isparkes/4-digit-wemos-clock/Hardware/controller-pcb/4DigitIN12Main.csv

Id | Designator | Package | Quantity | Designation | Supplier and ref
1 | L1 | Inductor-100mH | 1 | 100uH
2 | Y1 | Crystal_DS10_d1.0mm_l4.3mm_Vertical | 1 | Crystal
3 | C6,C8,C12,C14 | C025-024X044 | 4 | 100nF
4 | C11 | C025-024X044 | 1 | 680pF
5 | R2,R6,R7 | R-0207_2V | 3 | 10k
6 | R3 | R-0207_2V | 1 | R
7 | R4 | R-0207_2V | 1 | 390k
8 | R5 | R-0207_2V | 1 | 2k2
9 | U6 | K155ID1_DIL16 | 1 | K155ID1
10 | Q1 | TO-92_inline_2N3906 | 1 | 2N3906
11 | J2,J1 | Header_MA10-1_narrow | 2 | Conn_01x10
12 | MH1,MH1,MH1,MH1 | MountingHole_3.2mm_M3 | 4 | MountingHole_3.2mm_M3
13 | LED1,LED2,LED3,LED4 | WS2812B | 4 | WS2812B
14 | R1 | R_2W | 1 | 2R2 2W
15 | D1,D3 | Diode_DO-41_SOD81_Vertical_AnodeUp | 2 | UF4007
16 | D2 | Diode_DO-41_SOD81_Vertical_AnodeUp | 1 | 1N5819
17 | C4,C3,C2,C1 | C_1206_HandSoldering | 4 | 100nF
18 | Q2 | TO-220-3_H | 1 | IRF740
19 | U1 | 74HC595_DIL16 | 1 | 74HC595
20 | U5 | DS1307_DIL8 | 1 | DS1307+
21 | U4 | MC34063_DIL8 | 1 | MC34063A
22 | U2 | WeMos_D1_mini_board_flipped | 1 | WeMos_mini
23 | SV1 | Header_MA04-1 | 1 | CONN_FRONT
24 | BT1 | CR1220-CoinCell | 1 | Battery_Cell
25 | J4 | Header_MA03-1_Small | 1 | Conn_01x03
26 | W1 | TESTPAD_P1-13 | 1 | 5V
27 | W2,W3 | TESTPAD_P1-13 | 2 | GND
28 | W4 | TESTPAD_P1-13 | 1 | 170V
29 | J3 | Header_MA02-1 | 1 | CONN_01X02
30 | C13 | C_Radial_D6.3_L11.2_P2.5 | 1 | 2.2uF
31 | C10,C9,C7 | C_Radial_D6.3_L11.2_P2.5 | 3 | 220uF
32 | RV1 | Potentiometer_Trimmer_Bourns_3296X | 1 | POT
33 | SW1 | SW_Tactile_SPST_Angled_PTS645Vx31-2LFS | 1 | SW_DIP_x01
34 | U3 | TO-220-3_H | 1 | L7805
