isparkes/4-digit-wemos-clock/Hardware/in-2-display/4-Digit-IN-2-Dimensions.pdf

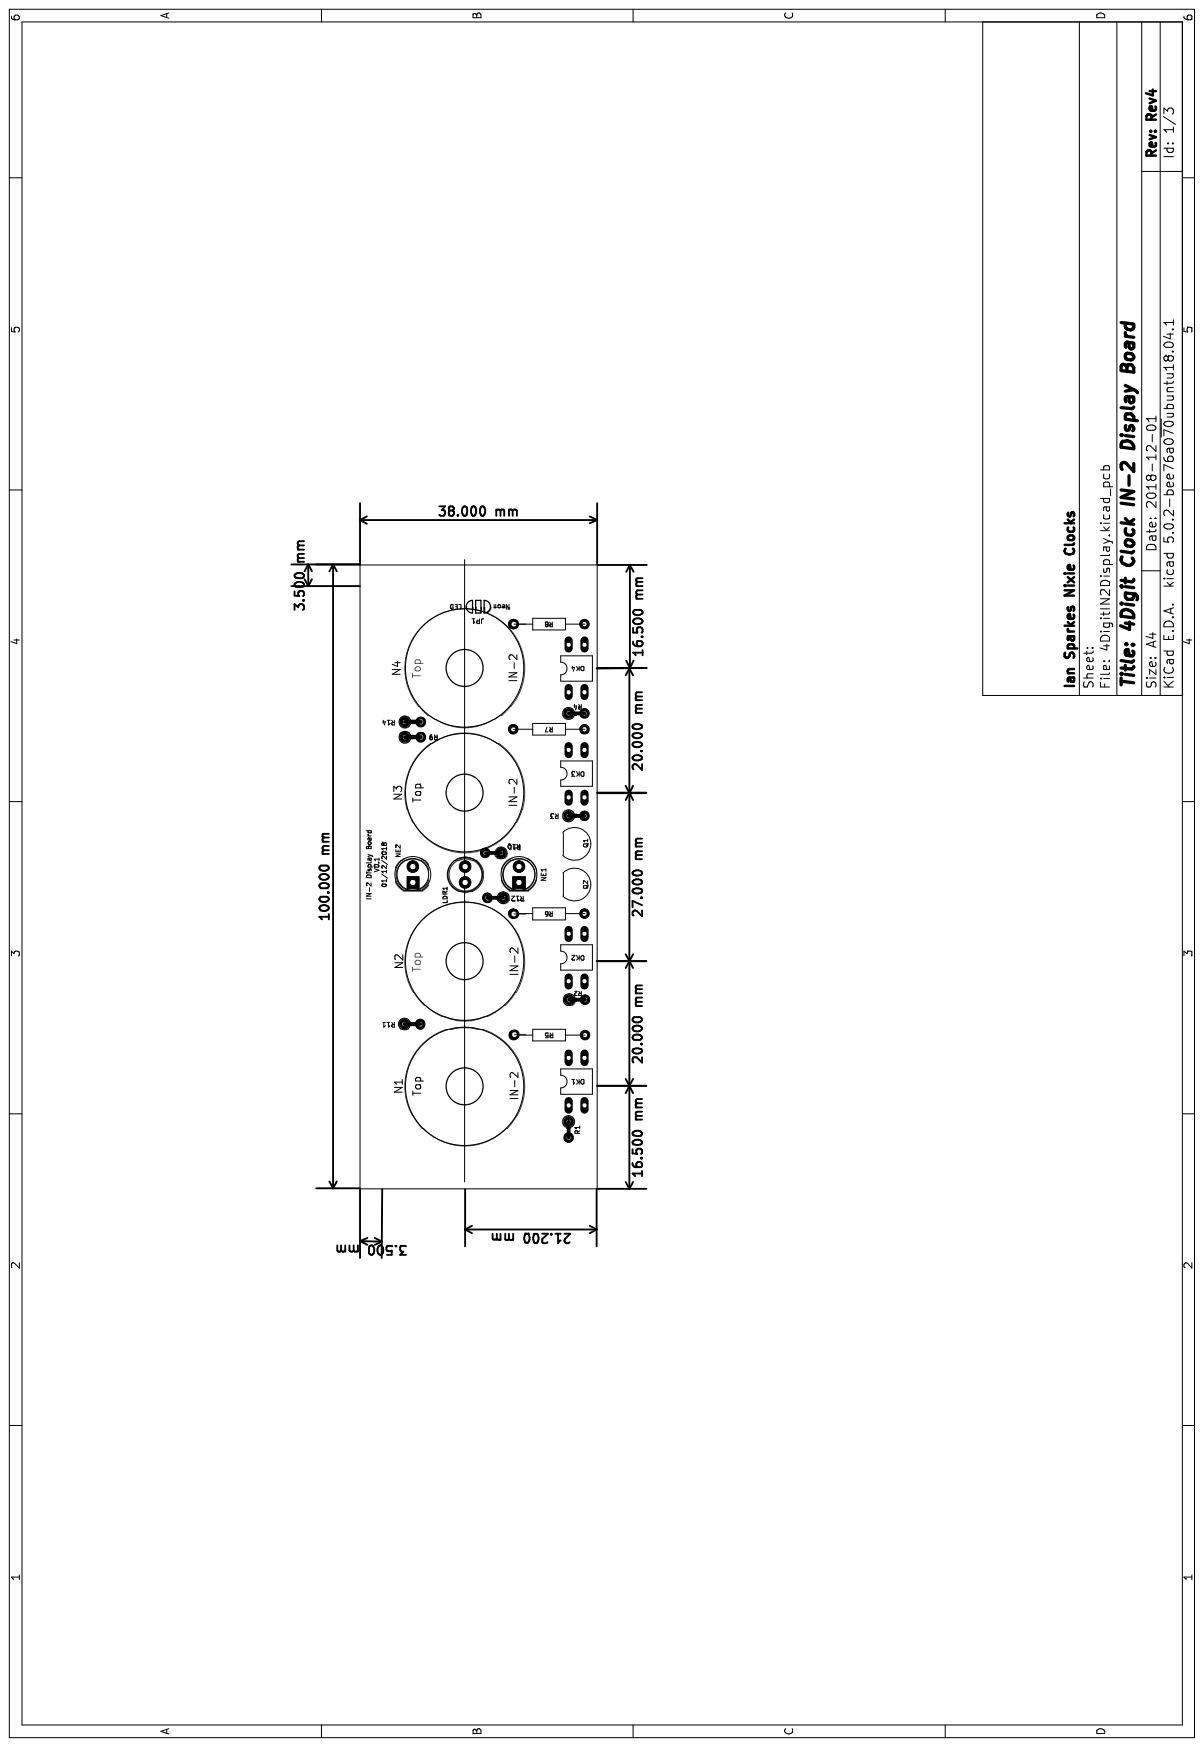
[picture p1: page 1]
