isparkes/4-digit-wemos-clock/Hardware/controller-pcb/4-Digit-Main-Dimensions.pdf

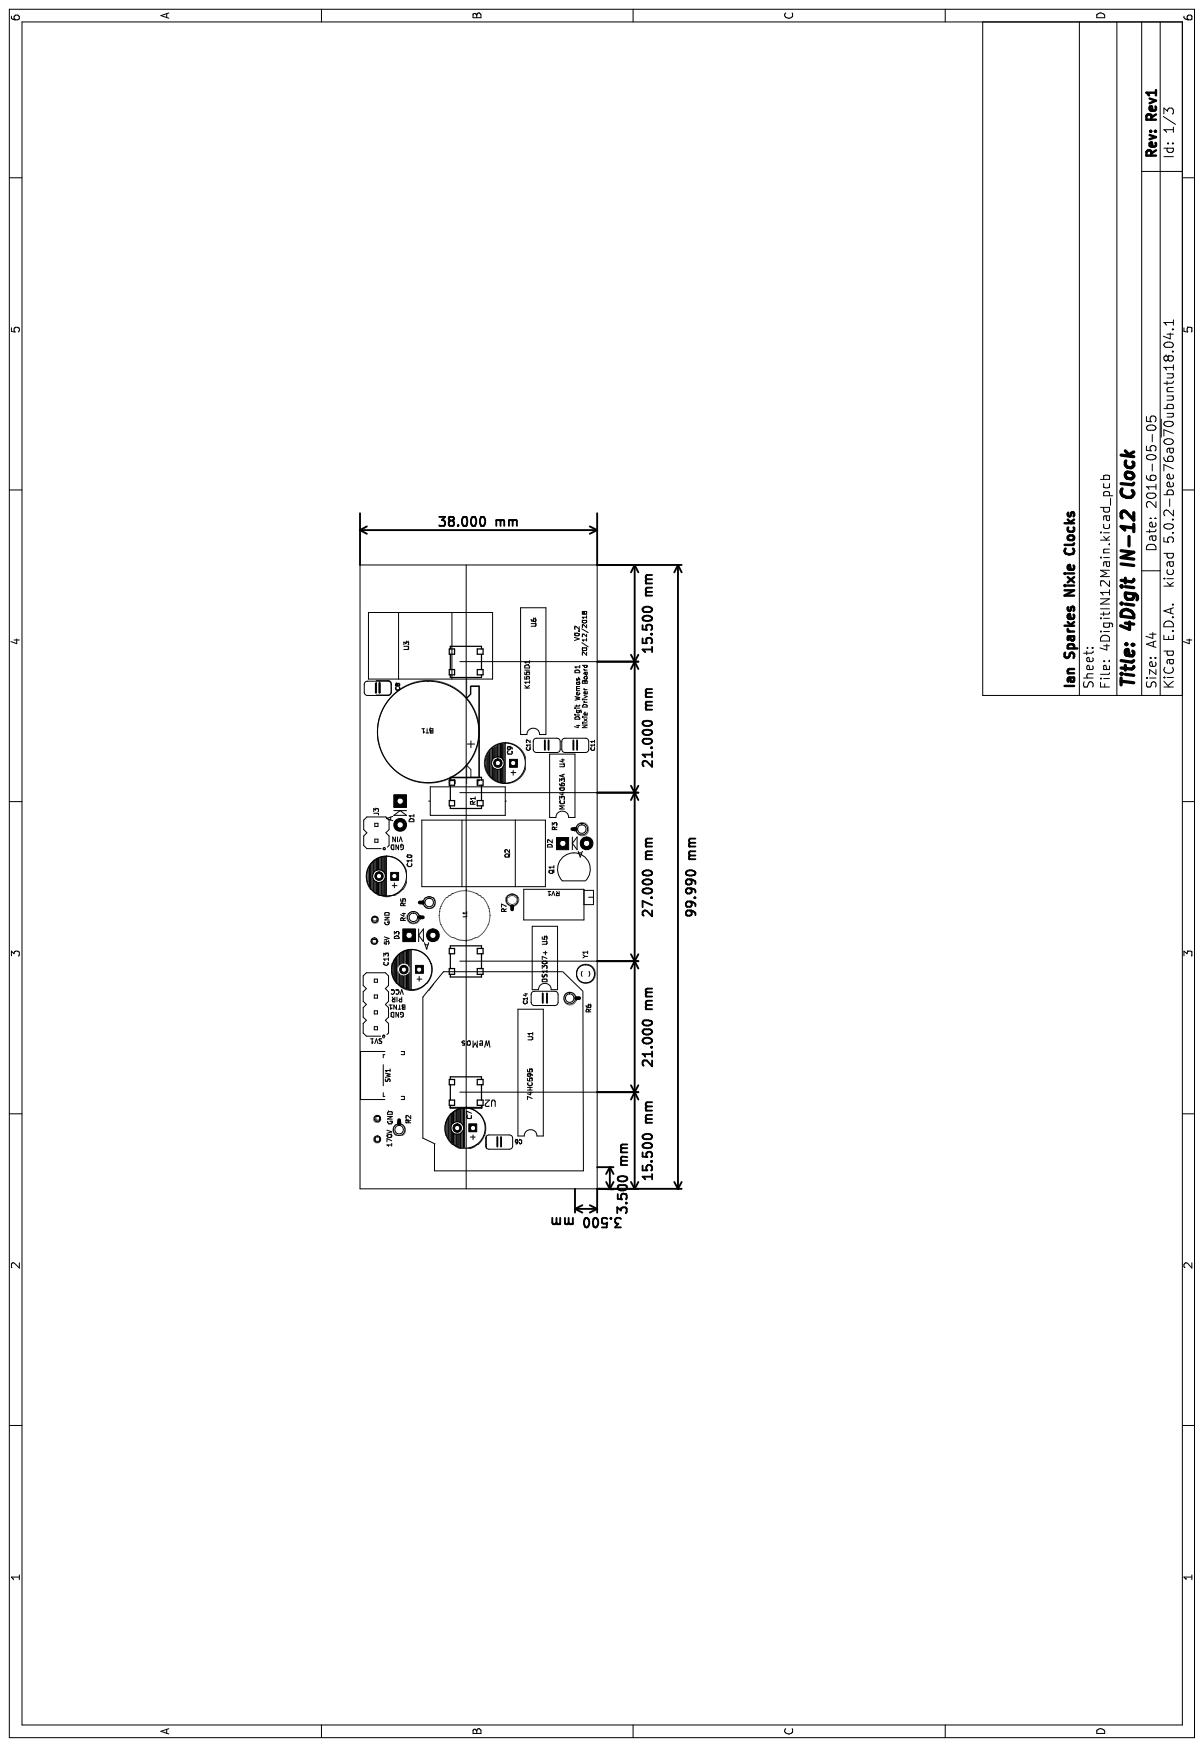
[picture p2: page 1]
