isparkes/4-digit-wemos-clock/Software/main.cpp

//**********************************************************************************
//* ESP8266 4-Digit Nixie Clock                                                    *
//* Copyright (c) 2018-2026 Ian Sparkes. All rights reserved.                      *
//*                                                                                *
//* Free for non-commercial use. Commercial use needs a licence from the author.   *
//* See the LICENSE file in the repository root for the full terms.                *
//* Contact: nixie@protonmail.ch  |  https://www.nixieclock.biz                    *
//**********************************************************************************

//**********************************************************************************
//* Main code for an ESP8266 based Nixie/VFD clock. Features:                      *
//*  - WiFi Clock configuration interface                                          *
//*  - Real Time Clock interface for DS1307+                                       *
//*  - Digit fading with configurable fade length                                  *
//*  - Digit scrollback with configurable scroll speed                             *
//*  - Configuration stored in Flash (JSON)                                        *
//*  - Low hardware component count (as much as possible done in code)             *
//*  - Single button operation with software debounce                              *
//*  - Automatic dimming, using a Light Dependent Resistor                         *
//*  - RGB back light management using individually addressable WS2812B            *
//*  - PIR/motion sensor to turn off display when no one is around                 *
//*                                                                                *
//*   Built with PlatformIO. The board settings below are configured in            *
//*   platformio.ini at the repository root, not in an IDE menu:                   *
//*                                                                                *
//*    Board: LOLIN (Wemos) D1 R2 & mini   (board = d1_mini)                       *
//*    Flash: 80MHz, CPU: 160MHz, Upload speed: 921600                             *
//*    Flash size: 4M (1M SPIFFS)          (eagle.flash.4m1m.ld)                   *
//*    lwIP Variant: v2 Higher Bandwidth (no features)                             *
//*                                                                                *
//*    pio run              - build                                                *
//*    pio run -t upload    - build and flash over USB                             *
//*    pio device monitor   - serial console at 115200 baud                        *
//*                                                                                *
//*  nixie@protonmail.ch                                                           *
//*                                                                                *
//**********************************************************************************
//**********************************************************************************
// Standard Libraries
#include <Arduino.h>
#include <Wire.h>

// Clock specific libraries. Versions are pinned in platformio.ini and fetched
// automatically on the first build - nothing needs installing by hand.
#include <TimeLib.h>            // paulstoffregen/Time (^1.6.1)
#include <NeoPixelBus.h>        // makuna/NeoPixelBus (^2.7.3)
#include <WiFiManager.h>        // tzapu/WiFiManager (^0.16.0)
#include <ArduinoJson.h>        // bblanchon/ArduinoJson (^5.13.2 - the v6/v7 API differs)

// Other parts of the code, broken out for clarity
#include "Globals.h"
#include "ClockButton.h"
#include "DebugManager.h"
#include "Transition.h"
#include "DisplayDefs.h"
#include "ClockUtils.h"
#include "ClockDefs.h"
#include "ESP_DS1307.h"
#include "LEDManager.h"
#include "NtpAsync.h"
#include "HtmlServer.h"
#include "SPIFFS.h"

// Feature configuration (append "_OFF" to switch off)
#define FEATURE_FADE
#define FEATURE_SCROLL
#define FEATURE_PREHEAT_OFF
#define FEATURE_STATUS_LEDS_OFF
#define FEATURE_PIR
#define FEATURE_EXT_LEDS_OFF
#define FEATURE_LED_MODES

#define DEBUG_OFF

NtpAsync ntpAsync;

//**********************************************************************************
//**********************************************************************************
//*                               ISR Display Multiplex                            *
//**********************************************************************************
//**********************************************************************************
#define INT_MUX_COUNTS         800
#define COUNTS_PER_DIGIT       20
#define COUNTS_PER_DIGIT_DIM   8

#define NEXT_DIGIT    B00000000
#define SWCH_DIGIT    B01000000
#define OFF__DIGIT    B10000000
#define BLNK_DIGIT    B11000000

volatile byte digitStep = 0;
volatile byte phaseStep = 0;

// Overall Phase array
byte phaseTime[][DIGIT_COUNT] = {{ 0, 0, 0, 0},
                       { 0, 0, 0, 0},
                       { 0, 0, 0, 0}};

// display arrays
byte valueBufferCurr[DIGIT_COUNT] = { 0, 0, 0, 0};
byte valueBufferPrev[DIGIT_COUNT] = { 0, 0, 0, 0};

// Cached values for this digit: updated only between digits
byte ptCache[] = {20 | NEXT_DIGIT, 0, 0};
byte na = 0;
byte cna = 0;

//**********************************************************************************
//* Forward declarations                                                           *
//*                                                                                *
//* The Arduino IDE generated these automatically from the .ino file. Under         *
//* PlatformIO this is a plain C++ translation unit, so they are declared here.     *
//**********************************************************************************
ICACHE_RAM_ATTR void digitOn(byte digit, byte value);
ICACHE_RAM_ATTR void digitOff(byte digit, byte value);
ICACHE_RAM_ATTR void displayUpdate();
void setDigit(byte digit, byte value, byte currValue, byte dimFactor, byte switchTime, bool blanked);
void performOncePerSecondProcessing();
void performOncePerMinuteProcessing();
void performOncePerHourProcessing();
void performOncePerDayProcessing();
void setLeds();
boolean checkPIR(unsigned long nowMillis);
boolean checkPIRInstalled();
void setNextMode(int displayMode);
void processCurrentMode(int displayMode);
void loadNumberArrayTime();
void loadNumberArrayMinsSecs();
void loadNumberArrayDayMonth();
void loadNumberArrayYear();
void loadNumberArrayLDR();
void loadNumberArrayTestDigits();
void loadNumberArrayConfInt(int confValue, byte mode);
void loadNumberArrayConfIntWide(int confValue);
void loadNumberArrayConfMode(byte mode);
void loadNumberArrayConfBool(boolean confValue, byte mode);
void loadNumberArrayIP(byte byte1);
void loadNumberArraySameValue(byte val);
void loadDisplaySetValueType();
void loadNumberArrayPOSTMessage(int postValue);
void outputDisplay();
byte getSwitchTime(byte offCount, byte fadeState, byte fadeSteps);
ICACHE_RAM_ATTR void ledsOn();
ICACHE_RAM_ATTR void ledsOff();
void applyBlanking();
void allNormal(boolean blanking);
void allBright();
void highlightMonthsDateFormat();
void highlightDaysDateFormat();
void highlight0and1();
void highlight2and3();
void allNormal();
void displayConfig();
void displayConfigWide();
void displayConfig3();
void displayConfig2();
void allBlanked();
void confBlink();
void showDisplayIP();
void resetSecond();
void incSecond();
void incMins();
void incHours();
void incDays();
void incMonths();
void incYears();
void setTimeFromServer(String timeString);
boolean checkBlanking();
String getPIRStateDisplay();
boolean getHoursBlanked();
void setTubesAndLEDSBlankMode();
void setDiagnosticLED(byte stepNumber, byte state);
void setPIRPullup(boolean newState);
void setNewNextMode(int newNextMode);
void newTimeUpdateReceived();
String getRTCTime(boolean setInternalTime);
void testRTCTimeProvider();
void setRTCTime();
int getDimmingFromLDR();
void factoryReset();
void saveToSpiffsIfChanged(boolean changed);
void rootPageHandler();
void timeServerPageHandler();
void resetPageHandler();
void clockConfigPageHandler();
void setDisplayValuePageHandler();
void utilityPageHandler();
void resetWiFiPageHandler();
void ntpUpdatePageHandler();
void factoryResetPageHandler();
void handleNotFound();
void localCSSHandler();
boolean getIsConnected();
void configModeCallback(WiFiManager *myWiFiManager);
void reconnectDroppedConnection();
void setServerPageHandlers();

// ************************************************************
// Set a digit with the given value, for a given digit
// ************************************************************
ICACHE_RAM_ATTR void digitOn(byte digit, byte value) {
  byte dispValue = value | anodes[digit];
  shiftOut(LATCHPin, DATA1Pin, CLOCKPin, dispValue);
}

// ************************************************************
// Turn the anodes off, but leave the cathodes alone
// ************************************************************
ICACHE_RAM_ATTR void digitOff(byte digit, byte value) {
  byte dispValue = value;
  shiftOut(LATCHPin, DATA1Pin, CLOCKPin, dispValue);
}

// ************************************************************
// Perform the shift out to the shift register
// ************************************************************
ICACHE_RAM_ATTR void shiftOut(uint8_t _loadPin,
              uint8_t _dataPin1,
              uint8_t _clockPin,
              uint8_t _val1) {
  uint8_t i;

  digitalWrite(_loadPin, LOW);
  for (i = 0; i < 8; i++) {
    digitalWrite(_dataPin1, !!(_val1 & (1 << (7 - i))));
    digitalWrite(_clockPin, HIGH);
    digitalWrite(_clockPin, LOW);
  }
  digitalWrite(_loadPin, HIGH);
}

// ************************************************************
// Interrupt routine for scheduled interrupts
//  - performs the programmed action and then schedules the next
//    interrupt for the next display update
//   - Each digit can consist of up to 3 phases:
//     1 - turn on for the "fade from" digit
//     2 - switch to the "fade to" digit
//     3 - turn the digit off
// ************************************************************
ICACHE_RAM_ATTR void displayUpdate() {
  byte phT = ptCache[phaseStep];

  unsigned int nextIntTime = phT & 0x3f;
  byte nextPhase = phT >> 6;

  // deal with "Blank this digit" - don't turn on at all - instead turn off and wait
  if (nextPhase == 3) {
    phaseStep = 2;
    nextPhase = NEXT_DIGIT;
  }

  switch (phaseStep) {
    case 0: {
      digitOn(digitStep, na);
      break;
    }
    case 1: {
      digitOn(digitStep, cna);
      break;
    }
    case 2: {
      digitOff(digitStep, na);
      break;
    }
  }

  phaseStep = nextPhase;
  if (phaseStep == 0) {

    digitStep++;
    if (digitStep > 3) {
      digitStep = 0;
      if (current_config.separatorDimFactor > 0) ledsOn();
    }

    // get the cached values when we change digit
    ptCache[0] = phaseTime[0][digitStep];
    ptCache[1] = phaseTime[1][digitStep];
    ptCache[2] = phaseTime[2][digitStep];
    na = valueBufferCurr[digitStep];
    cna = valueBufferPrev[digitStep];
  }
  
  if (digitStep == current_config.separatorDimFactor) {
    ledsOff();
  }

  timer1_write(nextIntTime * INT_MUX_COUNTS);
}

// ************************************************************
// Set the schedule and display values for a single digit, used in
// display preparation, not needed during at interrupt time
//
// digit: The digit to set 0..(DIGIT_COUNT-1)
// value: The value to show
// currValue: the value we are fading from
// dimFactor:   1..COUNTS_PER_DIGIT : COUNTS_PER_DIGIT = not dimmed
// switchTime: 0..COUNTS_PER_DIGIT-1 : 0 = no switch (undimmed)
// switchTime: 0..dimValue-1 : 0 = no switch (dimmed)
// ************************************************************
void setDigit(byte digit, byte value, byte currValue, byte dimFactor, byte switchTime, bool blanked) {
  valueBufferCurr[digit] = decodeDigit[value%10];
  valueBufferPrev[digit] = decodeDigit[currValue%10];

  if (dimFactor < 1) {
    dimFactor = 1; 
  }

  if (dimFactor > COUNTS_PER_DIGIT) {
    dimFactor = COUNTS_PER_DIGIT;
  }

  if (switchTime >= dimFactor) {
    switchTime = dimFactor - 1;
    if (switchTime < 1) {
      // can't show fading when we are so dim
      switchTime = 0;
    }
  }

  // Don't switch if the old and the new are the same
  if ((switchTime > 0) && (value == currValue)) {
    switchTime = 0;
  }

  if (blanked) {
    // blank in Ph0
    phaseTime[0][digit] = COUNTS_PER_DIGIT | BLNK_DIGIT;
    phaseTime[1][digit] = 0;
    phaseTime[2][digit] = 0;
  } else {
    // Undimmed
    if (dimFactor == COUNTS_PER_DIGIT) {
      if (switchTime == 0) {
        // simplest case, full brightness no switch, we just deal with Ph0
        phaseTime[0][digit] = COUNTS_PER_DIGIT | NEXT_DIGIT;
        phaseTime[1][digit] = 0;
        phaseTime[2][digit] = 0;
      } else {
        // doing a switch at full brightness, use Ph0 and Ph1
        phaseTime[0][digit] = switchTime | SWCH_DIGIT;
        phaseTime[1][digit] = (COUNTS_PER_DIGIT - switchTime) | NEXT_DIGIT;
        phaseTime[2][digit] = 0;
      }
    } else {
      // Dimmed
      if (switchTime == 0) {
        // dimmed no switch, use Ph0 and Ph2
        phaseTime[0][digit] = dimFactor | OFF__DIGIT;
        phaseTime[1][digit] = 0;
        phaseTime[2][digit] = (COUNTS_PER_DIGIT - dimFactor) | NEXT_DIGIT;      
      } else {
        // doing a switch while dimmed, use Ph0, Ph1 and Ph2
        phaseTime[0][digit] = switchTime | SWCH_DIGIT;
        phaseTime[1][digit] = (dimFactor - switchTime) | OFF__DIGIT;
        phaseTime[2][digit] = (COUNTS_PER_DIGIT - dimFactor) | NEXT_DIGIT;      
      }
    }
  }
}

//**********************************************************************************
//**********************************************************************************
//*                                    Setup                                       *
//**********************************************************************************
//**********************************************************************************
void setup()
{
  int postStep = 0;
  WiFiManager wifiManager;

  // set up the NTP component and wire up the "got time update" callback
  ntpAsync.setUp();
  NewTimeCallback ntcb = newTimeUpdateReceived;
  ntpAsync.setNewTimeCallback(ntcb);
  
#ifdef DEBUG
  setupDebug(true);
  debugMsg("");
  debugMsg("--------------------- START ---------------------");
  wifiManager.setDebugOutput(true);
  
  DebugCallback dbcb = debugMsg;
  ntpAsync.setDebugCallback(dbcb);
  ntpAsync.setDebugOutput(true);
#endif

  // Set up the display for the diags - this sets up the interrupt routine
  allBright();
  outputDisplay();

  debugMsg("Starting display interrupt handler");
  
  timer1_attachInterrupt(displayUpdate); // Add ISR Function
  timer1_enable(TIM_DIV16, TIM_EDGE, TIM_SINGLE);
  /* Dividers:
    TIM_DIV1 = 0,   //80MHz (80 ticks/us - 104857.588 us max)
    TIM_DIV16 = 1,  //5MHz (5 ticks/us - 1677721.4 us max)
    TIM_DIV256 = 3  //312.5Khz (1 tick = 3.2us - 26843542.4 us max)
  Reloads:
    TIM_SINGLE  0 //on interrupt routine you need to write a new value to start the timer again
    TIM_LOOP  1 //on interrupt the counter will start with the same value again
  */

  timer1_write(INT_MUX_COUNTS * COUNTS_PER_DIGIT);

  loadNumberArrayPOSTMessage(postStep++); // 0

  // Start I2C now so that the update from NTP can be sent to the RTC immediately
  Wire.begin(4, 5); // SDA = D2 = pin 4, SCL = D1 = pin 5
  debugMsg("I2C master started");

  loadNumberArrayPOSTMessage(postStep++); // 1

  ledManager.setUp();
  ledManager.setLDRRange(COUNTS_PER_DIGIT);
  debugMsg("LED manager started");

  setPinModes();

  loadNumberArrayPOSTMessage(postStep++); // 2
  button1.reset();

  setDiagnosticLED(DIAGS_SPIFFS, STATUS_YELLOW);
  loadNumberArrayPOSTMessage(postStep++); // 3
  delay(1000);

  loadNumberArrayPOSTMessage(postStep++); // 4
  for (int i = 0 ; i < 25 ; i++) {
    button1.checkButton(millis());
  }
  if (button1.isButtonPressedNow()) {
    setDiagnosticLED(DIAGS_SPIFFS, STATUS_BLUE);
    factoryReset();
    delay(1000);
    ESP.restart();
  }

  loadNumberArrayPOSTMessage(postStep++); // 5

  if (!spiffs.getConfigFromSpiffs(&current_config)) {
    if (spiffs.testMountSpiffs()) {
      debugManager.debugMsg("No config found - resetting everything");
      factoryReset();
      setDiagnosticLED(DIAGS_SPIFFS, STATUS_BLUE);
    } else {
      // we couldn't mount SPIFFS because no SPIFFS is available
      setDiagnosticLED(DIAGS_SPIFFS, STATUS_RED);
    }
  } else {
    setDiagnosticLED(DIAGS_SPIFFS, STATUS_GREEN);

    setWebAuthentication(current_config.webAuthentication);
    setWebUserName(current_config.webUsername);
    setWebPassword(current_config.webPassword);
    
    ntpAsync.setTZS(current_config.tzs);
    ntpAsync.setNtpPool(current_config.ntpPool);
    ntpAsync.setUpdateInterval(current_config.ntpUpdateInterval);

    ledManager.recalculateVariables();
  }
  
  // **********************************************************************

  // Clear down any spurious button action
  button1.reset();

  loadNumberArrayPOSTMessage(postStep++); // 6
  current_config.testMode = false;
  if (current_config.testMode) {
    debugMsg("Doing test sequence");
    boolean oldUseLDR = current_config.useLDR;
    byte oldBacklightMode = current_config.backlightMode;

    // reset the EEPROM values
    factoryReset();

    // turn off LDR
    current_config.useLDR = false;

    // turn off Scrollback
    current_config.scrollback = false;

    // set backlights to change with the displayed digits
    current_config.backlightMode = BACKLIGHT_COLOUR_TIME;

    // All the digits on fullledManager.
    allBright();

    int secCount = 0;
    int lastSecCount = 0;
    lastCheckMillis = millis();

    boolean inLoop = true;

    while (inLoop) {
      // Otherwise we get SOFT WDT
      yield();

      nowMillis = millis();
      if (nowMillis - lastCheckMillis > 1000) {
        lastCheckMillis = nowMillis;
        secCount++;
        secCount = secCount % 10;
      }

      loadNumberArraySameValue(secCount);

      // debugMsg("Setting display: " + String(secCount));
      outputDisplay();

      // debugMsg("Setting LEDs");
      if (lastSecCount != secCount) {
        setLeds();
        lastSecCount = secCount;
      }

      // debugMsg("Checing test mode exit condition");
      button1.checkButton(nowMillis);
      if (button1.isButtonPressedNow() && (secCount == 8)) {
        inLoop = false;
        current_config.testMode = false;
        spiffs.saveConfigToSpiffs(&current_config);
      }
    }

    current_config.useLDR = oldUseLDR;
    current_config.backlightMode = oldBacklightMode;
  }

  button1.reset();

  // **********************************************************************

  loadNumberArrayPOSTMessage(postStep++); // 7
  wifiManager.setConfigPortalTimeout(CONFIG_PORTAL_TIMEOUT);
  wifiManager.setAPCallback(configModeCallback);

  setDiagnosticLED(DIAGS_WIFI, STATUS_YELLOW);

  loadNumberArrayPOSTMessage(postStep++); // 8

  boolean connected = false;
  connected = wifiManager.autoConnect(WiFi.hostname().c_str(), "SetMeUp!");

  if (connected) {
    debugMsg("Connected!");
    setDiagnosticLED(DIAGS_WIFI, STATUS_GREEN);
  } else {
    debugMsg("Could NOT Connect");
    setDiagnosticLED(DIAGS_WIFI, STATUS_RED);
  }

  IPAddress apIP = WiFi.softAPIP();
  IPAddress myIP = WiFi.localIP();
  debugMsg("AP IP address: " + formatIPAsString(apIP));
  debugMsg("IP address: " + formatIPAsString(myIP));

  // If we lose the connection, we try to recover it
  WiFi.setAutoReconnect(true);

  // See if we can already get the time
  loadNumberArrayPOSTMessage(postStep++); // 9
  ntpAsync.getTimeFromNTP();
  setDiagnosticLED(DIAGS_NTP, STATUS_YELLOW);
  long startSeachMs = millis();
  bool needUpdate = true;
  while(((millis() - startSeachMs) < 10000) && needUpdate) {
    delay(500);
    ntpAsync.getTimeFromNTP();
    if (ntpAsync.ntpTimeValid(millis()) > 0) {
      debugMsg("Got update from NTP, exiting loop");
      needUpdate = false;
    }
  }

  if (needUpdate) {
    setDiagnosticLED(DIAGS_NTP, STATUS_RED);
  } else {
    setDiagnosticLED(DIAGS_NTP, STATUS_GREEN);
  }

  loadNumberArrayPOSTMessage(postStep++); // 10
  setServerPageHandlers();
  server.begin();
  debugMsg("HTTP server started");

  // Enable OTA updates
  loadNumberArrayPOSTMessage(postStep++); // 11
  httpUpdater.setup(&server, "/update", "admin", "update");

  loadNumberArrayPOSTMessage(postStep++); // 12
  if (mdns.begin(WiFi.hostname(), WiFi.localIP())) {
    debugMsg("MDNS responder started as http://" + WiFi.hostname() + ".local");
    mdns.addService("http", "tcp", 80);
  }

  loadNumberArrayPOSTMessage(postStep++); // 13
  setPIRPullup(current_config.usePIRPullup);

  // initialise the internal time (in case we don't find the time provider)
  nowMillis = millis();

  loadNumberArrayPOSTMessage(postStep++); // 14
  testRTCTimeProvider();
  if (useRTC) {
    getRTCTime(true);
    setDiagnosticLED(DIAGS_RTC, STATUS_GREEN);
  } else {
    setDiagnosticLED(DIAGS_RTC, STATUS_RED);
  }

  // Note that we had an RTC to allow the indicator DP to have meaning
  onceHadAnRTC = useRTC;

  // Show the version for 1 s
  tempDisplayMode = TEMP_MODE_VERSION;
  tempDisplayModeDuration = TEMP_DISPLAY_MODE_DUR_MS;

  // don't blank anything right now
  blanked = false;
  setTubesAndLEDSBlankMode();
  loadNumberArrayPOSTMessage(postStep++); // 15

  // mark that we have done the EEPROM setup
  current_config.testMode = false;
  spiffs.saveConfigToSpiffs(&current_config);

  debugMsg("Exit startup in 1 second");
  spiffs.getStatsFromSpiffs(&current_stats);
  loadNumberArrayPOSTMessage(postStep++); // 16
  ledManager.setDayOfWeek(weekday());
  delay(1000);
}

//**********************************************************************************
//**********************************************************************************
//*                              Main loop                                         *
//**********************************************************************************
//**********************************************************************************
void loop()
{
  server.handleClient();
  mdns.update();

  nowMillis = millis();
  static uint16_t lastSec = second();

  // shows us how fast the inner loop is running
  impressionsPerSec++;

  // -------------------------------------------------------------------------------

  if (lastSec != second()) {
    lastSec = second();
    lastCheckMillis = nowMillis;

    if ((second() == 0) && (!triggeredThisSec)) {
      if ((minute() == 0)) {
        if (hour() == 0) {
          performOncePerDayProcessing();
        }
        performOncePerHourProcessing();
      }
      performOncePerMinuteProcessing();
    }
    performOncePerSecondProcessing();

    // Make sure we don't call multiple times
    triggeredThisSec = true;

    if ((second() > 0) && triggeredThisSec) {
      triggeredThisSec = false;
    }
  }

  // Check button, we evaluate below
  button1.checkButton(nowMillis);

  // ******* Preview the next display mode *******
  // What is previewed here will get actioned when
  // the button is released
  if (button1.isButtonPressed2S()) {
    // Just jump back to the start
    nextMode = MODE_MIN;
  } else if (button1.isButtonPressed1S()) {
    nextMode = currentMode + 1;

    if (nextMode > MODE_MAX) {
      nextMode = MODE_MIN;
    }
  }

  // ******* Set the display mode *******
  if (button1.isButtonPressedReleased2S()) {
    currentMode = MODE_MIN;

    // Store the latest config if we exit the config mode
    spiffs.saveConfigToSpiffs(&current_config);

    // Preset the display
    allNormal(DO_NOT_APPLY_LEAD_0_BLANK);

    nextMode = currentMode;
  } else if (button1.isButtonPressedReleased1S()) {
    currentMode++;

    if (currentMode > MODE_MAX) {
      currentMode = MODE_MIN;

      // Store the latest config if we exit the config mode
      spiffs.saveConfigToSpiffs(&current_config);

      // Preset the display
      allNormal(DO_NOT_APPLY_LEAD_0_BLANK);
    }

    nextMode = currentMode;
  }

  // ************* Process the modes *************
  if (nextMode != currentMode) {
    setNextMode(nextMode);
  } else {
    processCurrentMode(currentMode);
  }

  // get the LDR ambient light reading
  ldrValue = getDimmingFromLDR();
  ledManager.setLDRValue(ldrValue);
  fadeStep = ldrValue / current_config.fadeSteps;

  // Prepare the tick and backlight LEDs
  setLeds();

  if (digitalRead(pirPin) == HIGH) {
    pirConsecutiveCounts++;
  }

  delay(10);

  outputDisplay();
}

// ************************************************************
// Called once per second
// ************************************************************
void performOncePerSecondProcessing() {
  // Store the current value and reset
  lastImpressionsPerSec = impressionsPerSec;
  impressionsPerSec = 0;

  // Change the direction of the pulse
  upOrDown = !upOrDown;

  // If we are in temp display mode, decrement the count
  if (tempDisplayModeDuration > 0) {
    if (tempDisplayModeDuration > 1000) {
      tempDisplayModeDuration -= 1000;
    } else {
      tempDisplayModeDuration = 0;
    }
  }

  // decrement the blanking supression counter
  if (blankSuppressedMillis > 0) {
    if (blankSuppressedMillis > 1000) {
      blankSuppressedMillis -= 1000;
    } else {
      blankSuppressedMillis = 0;
    }
  }

  // Get the blanking status, this may be overridden by blanking suppression
  // Only blank if we are in TIME mode
  if (currentMode == MODE_TIME) {
    boolean pirBlanked = checkPIR(nowMillis);
    boolean nativeBlanked = checkBlanking();

    // Check if we are in blanking suppression mode
    blanked = (nativeBlanked || pirBlanked) && (blankSuppressedMillis == 0);

    if (blanked) {
      debugMsg("blanked");
      if (pirBlanked)
        debugMsg(" -> PIR");
      if (nativeBlanked)
        debugMsg(" -> Native");
    }

    // reset the blanking period selection timer
    if (nowMillis > blankSuppressedSelectionTimoutMillis) {
      blankSuppressedSelectionTimoutMillis = 0;
      blankSuppressStep = 0;
    }
  } else {
    blanked = false;
  }

  setTubesAndLEDSBlankMode();

  // Decrement the value display counter
  // 0xff means "forever", so don't decrement it
  if ((valueDisplayTime > 0) && (valueDisplayTime < 0xff)) {
    valueDisplayTime--;
  }

  // Reset PIR debounce
  pirConsecutiveCounts = 0;

  if (ntpAsync.getNextUpdate(nowMillis) < 0) {
    ntpAsync.getTimeFromNTP();
  }
}

// ************************************************************
// Called once per minute
// ************************************************************
void performOncePerMinuteProcessing() {
  debugMsg("---> OncePerMinuteProcessing");

  debugMsg("nu: " + String(ntpAsync.getNextUpdate(nowMillis)));

  // Set the internal time to the time from the RTC even if we are still in
  // NTP valid time. This is more accurate than using the internal time source
  getRTCTime(true);

  // Usage stats
  uptimeMins++;

  if (!blankTubes) {
    tubeOnTimeMins++;
  }
}

// ************************************************************
// Called once per hour
// ************************************************************
void performOncePerHourProcessing() {
  debugMsg("---> OncePerHourProcessing");
  reconnectDroppedConnection();
}

// ************************************************************
// Called once per day
// ************************************************************
void performOncePerDayProcessing() {
  debugMsg("---> OncePerDayProcessing");
  spiffs.saveStatsToSpiffs(&current_stats);
  ledManager.setDayOfWeek(weekday());
}

// ************************************************************
// Set the seconds tick led(s) and the back lights
// ************************************************************
void setLeds()
{
  int secsDelta;
  int secsDeltaAbs = (nowMillis - lastCheckMillis);
  if (upOrDown) {
    secsDelta = (nowMillis - lastCheckMillis);
  } else {
    secsDelta = 1000 - (nowMillis - lastCheckMillis);
  }

  if (blankSeparators) {
    led1State = false;
    led2State = false;
  } else {
    switch (current_config.ledMode) {
      case LED_RAILROAD:
        {
          if (upOrDown) {
            led1State = true;
            led2State = false;
          } else {
            led1State = false;
            led2State = true;
          }
          break;
        }
      case LED_BLINK_SLOW:
        {
          if (upOrDown) {
            led1State = true;
            led2State = true;
          } else {
            led1State = false;
            led2State = false;
          }
          break;
        }
      case LED_BLINK_FAST:
        {
          if (secsDeltaAbs < 500) {
            led1State = true;
            led2State = true;
          } else {
            led1State = false;
            led2State = false;
          }
          break;
        }
      case LED_BLINK_DBL:
        {
          if ((secsDeltaAbs < 100) || ((secsDeltaAbs > 200) && (secsDeltaAbs < 300))) {
            led1State = true;
            led2State = true;
          } else {
            led1State = false;
            led2State = false;
          }
          break;
        }
      case LED_ON:
        {
          led1State = true;
          led2State = true;
          break;
        }
      case LED_OFF:
        {
          led1State = false;
          led2State = false;
          break;
        }
      case LED_AM_PM:
        {
          led1State = !isAM(); // bottom LED
          led2State = isAM(); // top LED
          break;
        }
    }
  }


  // output the backlight/underlight LEDs
  ledManager.setPulseValue(secsDelta);  
  ledManager.processLedStatus();
  
  blinkState = (secsDeltaAbs % 500) > 250;
}

// ************************************************************
// Check the PIR status. If we don't have a PIR installed, we
// don't want to respect the pin value, because it would defeat
// normal day blanking. The first time the PIR takes the pin low
// we mark that we have a PIR and we should start to respect
// the sensor over configured blanking.
// Returns true if PIR sensor is installed and we are blanked
//
// To deal with noise, we use a counter to detect a number of
// consecutive counts before counting the PIR as "detected"
// ************************************************************
boolean checkPIR(unsigned long nowMillis) {
  if (pirConsecutiveCounts > (lastImpressionsPerSec / 2)) {
    pirLastSeen = nowMillis;
    return false;
  } else {
    if (!pirInstalled) debugMsg("Marking PIR as installed");
    pirInstalled = true;
    if (nowMillis > (pirLastSeen + (current_config.pirTimeout * 1000))) {
      return true;
    } else {
      return false;
    }
  }
}

// ************************************************************
// Check if the PIR sensor is installed
// ************************************************************
boolean checkPIRInstalled() {
  return pirInstalled;
}

// ************************************************************
// Show the preview of the next mode - we stay in this mode until the
// button is released
// ************************************************************
void setNextMode(int displayMode) {
  // turn off blanking
  blanked = false;
  setTubesAndLEDSBlankMode();

  switch (displayMode) {
    case MODE_TIME: {
        loadNumberArrayTime();
        allNormal(APPLY_LEAD_0_BLANK);
        break;
      }
    case MODE_HOURS_SET: {
        if (ntpAsync.ntpTimeValid(nowMillis)) {
          // skip past the time and date settings
          setNewNextMode(MODE_12_24);
        }
        loadNumberArrayTime();
        highlight0and1();
        break;
      }
    case MODE_MINS_SET: {
        loadNumberArrayTime();
        highlight2and3();
        break;
      }
    case MODE_SECS_SET: {
        loadNumberArrayMinsSecs();
        highlight2and3();
        break;
      }
    case MODE_DAYS_SET: {
        loadNumberArrayDayMonth();
        highlightDaysDateFormat();
        break;
      }
    case MODE_MONTHS_SET: {
        loadNumberArrayDayMonth();
        highlightMonthsDateFormat();
        break;
      }
    case MODE_YEARS_SET: {
        loadNumberArrayYear();
        highlight2and3();
        break;
      }
    case MODE_12_24: {
        loadNumberArrayConfBool(current_config.hourMode, displayMode);
        displayConfig();
        break;
      }
    case MODE_LEAD_BLANK: {
        loadNumberArrayConfBool(current_config.blankLeading, displayMode);
        displayConfig();
        break;
      }
    case MODE_SCROLLBACK: {
        loadNumberArrayConfBool(current_config.scrollback, displayMode);
        displayConfig();
        break;
      }
    case MODE_FADE: {
        loadNumberArrayConfBool(current_config.fade, displayMode);
        displayConfig();
        break;
      }
    case MODE_DATE_FORMAT: {
        loadNumberArrayConfInt(current_config.dateFormat, displayMode);
        displayConfig();
        break;
      }
    case MODE_DAY_BLANKING: {
        loadNumberArrayConfInt(current_config.dayBlanking, displayMode);
        displayConfig();
        break;
      }
    case MODE_HR_BLNK_START: {
        if ((current_config.dayBlanking == DAY_BLANKING_NEVER) ||
            (current_config.dayBlanking == DAY_BLANKING_WEEKEND) ||
            (current_config.dayBlanking == DAY_BLANKING_WEEKDAY) ||
            (current_config.dayBlanking == DAY_BLANKING_ALWAYS)) {
          // Skip past the start and end hour if the blanking mode says it is not relevant
          setNewNextMode(MODE_USE_LDR);
        }

        loadNumberArrayConfInt(current_config.blankHourStart, displayMode);
        displayConfig();
        break;
      }
    case MODE_HR_BLNK_END: {
        loadNumberArrayConfInt(current_config.blankHourEnd, displayMode);
        displayConfig();
        break;
      }
    case MODE_BLANK_MODE: {
        loadNumberArrayConfInt(current_config.blankMode, displayMode);
        displayConfig();
        break;
      }
    case MODE_USE_LDR: {
        loadNumberArrayConfBool(current_config.useLDR, displayMode);
        displayConfig();
        break;
      }
    case MODE_FADE_STEPS_UP:
    case MODE_FADE_STEPS_DOWN: {
        loadNumberArrayConfInt(current_config.fadeSteps, displayMode);
        displayConfig();
        break;
      }
    case MODE_DISPLAY_SCROLL_STEPS_UP:
    case MODE_DISPLAY_SCROLL_STEPS_DOWN: {
        loadNumberArrayConfInt(current_config.scrollSteps, displayMode);
        displayConfig();
        break;
      }
    case MODE_PIR_TIMEOUT_UP:
    case MODE_PIR_TIMEOUT_DOWN: {
        loadNumberArrayConfMode(displayMode);
        displayConfigWide();
        break;
      }
    case MODE_SLOTS_MODE: {
        loadNumberArrayConfInt(current_config.slotsMode, displayMode);
        displayConfig();
        break;
      }
    case MODE_BACKLIGHT_MODE: {
        loadNumberArrayConfInt(current_config.backlightMode, displayMode);
        displayConfig();
        break;
      }
    case MODE_RED_CNL: {
        if (current_config.backlightMode != BACKLIGHT_FIXED)  {
          // Skip if we are in cycle mode
          setNewNextMode(MODE_CYCLE_SPEED);
        }
        loadNumberArrayConfInt(current_config.redCnl, displayMode);
        displayConfig();
        break;
      }
    case MODE_GRN_CNL: {
        loadNumberArrayConfInt(current_config.grnCnl, displayMode);
        displayConfig();
        break;
      }
    case MODE_BLU_CNL: {
        loadNumberArrayConfInt(current_config.bluCnl, displayMode);
        displayConfig();
        break;
      }
    case MODE_CYCLE_SPEED: {
        if (current_config.backlightMode != BACKLIGHT_CYCLE) {
          // Show only if we are in cycle mode
          setNewNextMode(MODE_USE_PULSE);
        }
        loadNumberArrayConfInt(current_config.cycleSpeed, displayMode);
        displayConfig();
        break;
      }
    case MODE_MIN_DIM_UP:
    case MODE_MIN_DIM_DOWN: {
        loadNumberArrayConfInt(current_config.minDim, displayMode);
        displayConfig();
        break;
      }
    case MODE_USE_PIR_PULLUP: {
        loadNumberArrayConfBool(current_config.usePIRPullup, displayMode);
        displayConfig();
        break;
      }
    case MODE_LED_BLINK: {
        loadNumberArrayConfInt(current_config.ledMode, displayMode);
        displayConfig();
        break;
      }
    case MODE_USE_PULSE: {
        loadNumberArrayConfBool(current_config.useBLPulse, displayMode);
        displayConfig();
        break;
      }
    case MODE_USE_DIM: {
        loadNumberArrayConfBool(current_config.useBLDim, displayMode);
        displayConfig();
        break;
      }
    case MODE_VERSION: {
        loadNumberArrayConfInt(SOFTWARE_VERSION, displayMode);
        displayConfig();
        break;
      }
    case MODE_TUBE_TEST: {
        loadNumberArrayTestDigits();
        allNormal();
        break;
      }
  }
}

// ************************************************************
// Show the next mode - once the button is released
// ************************************************************
void processCurrentMode(int displayMode) {
  switch (displayMode) {
    case MODE_TIME: {
        if (button1.isButtonPressedAndReleased()) {
          // Deal with blanking first
          if ((nowMillis < blankSuppressedSelectionTimoutMillis) || blanked) {
            if (blankSuppressedSelectionTimoutMillis == 0) {
              // Apply 5 sec tineout for setting the suppression time
              blankSuppressedSelectionTimoutMillis = nowMillis + TEMP_DISPLAY_MODE_DUR_MS;
            }

            blankSuppressStep++;
            if (blankSuppressStep > 3) {
              blankSuppressStep = 3;
            }

            if (blankSuppressStep == 1) {
              blankSuppressedMillis = 10000;
            } else if (blankSuppressStep == 2) {
              blankSuppressedMillis = 3600000;
            } else if (blankSuppressStep == 3) {
              blankSuppressedMillis = 3600000 * 4;
            }
            blanked = false;
            setTubesAndLEDSBlankMode();
          } else {
            // Always start from the first mode, or increment the temp mode if we are already in a display
            if (tempDisplayModeDuration > 0) {
              tempDisplayModeDuration = TEMP_DISPLAY_MODE_DUR_MS;
              tempDisplayMode++;
            } else {
              tempDisplayMode = TEMP_MODE_MIN;
            }

            if (tempDisplayMode > TEMP_MODE_MAX) {
              tempDisplayMode = TEMP_MODE_MIN;
            }

            tempDisplayModeDuration = TEMP_DISPLAY_MODE_DUR_MS;
          }
        }

        if (tempDisplayModeDuration > 0) {
          blanked = false;
          setTubesAndLEDSBlankMode();

          if (tempDisplayMode == TEMP_MODE_SECS) {
            loadNumberArrayMinsSecs();
          }

          if (tempDisplayMode == TEMP_MODE_DATE) {
            loadNumberArrayDayMonth();
          }

          if (tempDisplayMode == TEMP_MODE_LDR) {
            loadNumberArrayLDR();
          }

          if (tempDisplayMode == TEMP_MODE_VERSION) {
            loadNumberArrayConfInt(SOFTWARE_VERSION, 0);
          }

          if (tempDisplayMode == TEMP_IP_ADDR1) {
            if (getIsConnected()) {
              IPAddress myIP = WiFi.localIP();
              loadNumberArrayIP(myIP[0]);
              showDisplayIP();
            } else {
              // we can't show the IP address if we have the RTC, just skip
              tempDisplayMode++;
            }
          }

          if (tempDisplayMode == TEMP_IP_ADDR2) {
            if (getIsConnected()) {
              IPAddress myIP = WiFi.localIP();
              loadNumberArrayIP(myIP[1]);
              showDisplayIP();
            } else {
              // we can't show the IP address if we have the RTC, just skip
              tempDisplayMode++;
            }
          }

          if (tempDisplayMode == TEMP_IP_ADDR3) {
            if (getIsConnected()) {
              IPAddress myIP = WiFi.localIP();
              loadNumberArrayIP(myIP[2]);
              showDisplayIP();
            } else {
              // we can't show the IP address if we have the RTC, just skip
              tempDisplayMode++;
            }
          }

          if (tempDisplayMode == TEMP_IP_ADDR4) {
            if (getIsConnected()) {
              IPAddress myIP = WiFi.localIP();
              loadNumberArrayIP(myIP[3]);
              showDisplayIP();
            } else {
              // we can't show the IP address if we have the RTC, just skip
              tempDisplayMode++;
            }
          }

          if (tempDisplayMode == TEMP_MODE_IMPR) {
            loadNumberArrayConfIntWide(lastImpressionsPerSec);
          }

          allNormal(DO_NOT_APPLY_LEAD_0_BLANK);

        } else {
          if (current_config.slotsMode > SLOTS_MODE_MIN) {
            if (second() == 50) {

              // initialise the slots values
              loadNumberArrayDayMonth();
              transition.setAlternateValues();
              loadNumberArrayTime();
              transition.setRegularValues();
              allNormal(DO_NOT_APPLY_LEAD_0_BLANK);

              transition.start(nowMillis);
            }

            // initialise the slots mode
            boolean msgDisplaying = false;
            switch (current_config.slotsMode) {
              case SLOTS_MODE_1M_SCR_SCR:
                {
                  msgDisplaying = transition.scrollInScrambleOut(nowMillis);
                  break;
                }
            }

            // Continue slots
            if (!msgDisplaying) {
              // no slots mode, check if we are in valueDisplayMode
              if (valueDisplayTime > 0) {
                loadNumberArrayConfIntWide(valueToShow);
                loadDisplaySetValueType();
              } else {
                // normal time
                loadNumberArrayTime();
                allNormal(APPLY_LEAD_0_BLANK);
              }
            }
          } else {
            // no slots mode, check if we are in valueDisplayMode
            if (valueDisplayTime > 0) {
              loadNumberArrayConfIntWide(valueToShow);
              loadDisplaySetValueType();
            } else {
              // normal time
              loadNumberArrayTime();
              allNormal(APPLY_LEAD_0_BLANK);
            }
          }
        }
        break;
      }
    case MODE_HOURS_SET: {
        if (button1.isButtonPressedAndReleased()) {
          incHours();
        }
        loadNumberArrayTime();
        highlight0and1();
        break;
      }
    case MODE_MINS_SET: {
        if (button1.isButtonPressedAndReleased()) {
          incMins();
        }
        loadNumberArrayTime();
        highlight2and3();
        break;
      }
    case MODE_SECS_SET: {
        if (button1.isButtonPressedAndReleased()) {
          resetSecond();
        }
        loadNumberArrayMinsSecs();
        highlight2and3();
        break;
      }
    case MODE_DAYS_SET: {
        if (button1.isButtonPressedAndReleased()) {
          incDays();
        }
        loadNumberArrayDayMonth();
        highlightDaysDateFormat();
        break;
      }
    case MODE_MONTHS_SET: {
        if (button1.isButtonPressedAndReleased()) {
          incMonths();
        }
        loadNumberArrayDayMonth();
        highlightMonthsDateFormat();
        break;
      }
    case MODE_YEARS_SET: {
        if (button1.isButtonPressedAndReleased()) {
          incYears();
        }
        loadNumberArrayYear();
        highlight2and3();
        break;
      }
    case MODE_12_24: {
        if (button1.isButtonPressedAndReleased()) {
          current_config.hourMode = !current_config.hourMode;
        }
        loadNumberArrayConfBool(current_config.hourMode, displayMode);
        displayConfig();
        break;
      }
    case MODE_LEAD_BLANK: {
        if (button1.isButtonPressedAndReleased()) {
          current_config.blankLeading = !current_config.blankLeading;
        }
        loadNumberArrayConfBool(current_config.blankLeading, displayMode);
        displayConfig();
        break;
      }
    case MODE_SCROLLBACK: {
        if (button1.isButtonPressedAndReleased()) {
          current_config.scrollback = !current_config.scrollback;
        }
        loadNumberArrayConfBool(current_config.scrollback, displayMode);
        displayConfig();
        break;
      }
    case MODE_FADE: {
        if (button1.isButtonPressedAndReleased()) {
          current_config.fade = !current_config.fade;
        }
        loadNumberArrayConfBool(current_config.fade, displayMode);
        displayConfig();
        break;
      }
    case MODE_DATE_FORMAT: {
        if (button1.isButtonPressedAndReleased()) {
          current_config.dateFormat++;
          if (current_config.dateFormat > DATE_FORMAT_MAX) {
            current_config.dateFormat = DATE_FORMAT_MIN;
          }
        }
        loadNumberArrayConfInt(current_config.dateFormat, displayMode);
        displayConfig();
        break;
      }
    case MODE_DAY_BLANKING: {
        if (button1.isButtonPressedAndReleased()) {
          current_config.dayBlanking++;
          if (current_config.dayBlanking > DAY_BLANKING_MAX) {
            current_config.dayBlanking = DAY_BLANKING_MIN;
          }
        }
        loadNumberArrayConfInt(current_config.dayBlanking, displayMode);
        displayConfig();
        break;
      }
    case MODE_HR_BLNK_START: {
        if (button1.isButtonPressedAndReleased()) {
          current_config.blankHourStart++;
          if (current_config.blankHourStart > HOURS_MAX) {
            current_config.blankHourStart = 0;
          }
        }
        loadNumberArrayConfInt(current_config.blankHourStart, displayMode);
        displayConfig();
        break;
      }
    case MODE_HR_BLNK_END: {
        if (button1.isButtonPressedAndReleased()) {
          current_config.blankHourEnd++;
          if (current_config.blankHourEnd > HOURS_MAX) {
            current_config.blankHourEnd = 0;
          }
        }
        loadNumberArrayConfInt(current_config.blankHourEnd, displayMode);
        displayConfig();
        break;
      }
    case MODE_BLANK_MODE: {
        if (button1.isButtonPressedAndReleased()) {
          current_config.blankMode++;
          if (current_config.blankMode > BLANK_MODE_MAX) {
            current_config.blankMode = BLANK_MODE_MIN;
          }
        }
        loadNumberArrayConfInt(current_config.blankMode, displayMode);
        displayConfig();
        break;
      }
    case MODE_USE_LDR: {
        if (button1.isButtonPressedAndReleased()) {
          current_config.useLDR = !current_config.useLDR;
        }
        loadNumberArrayConfBool(current_config.useLDR, displayMode);
        displayConfig();
        break;
      }
    case MODE_FADE_STEPS_UP: {
        if (button1.isButtonPressedAndReleased()) {
          current_config.fadeSteps++;
          if (current_config.fadeSteps > FADE_STEPS_MAX) {
            current_config.fadeSteps = FADE_STEPS_MIN;
          }
        }
        loadNumberArrayConfInt(current_config.fadeSteps, displayMode);
        displayConfig();
        fadeStep = COUNTS_PER_DIGIT / current_config.fadeSteps;
        break;
      }
    case MODE_FADE_STEPS_DOWN: {
        if (button1.isButtonPressedAndReleased()) {
          current_config.fadeSteps--;
          if (current_config.fadeSteps < FADE_STEPS_MIN) {
            current_config.fadeSteps = FADE_STEPS_MAX;
          }
        }
        loadNumberArrayConfInt(current_config.fadeSteps, displayMode);
        displayConfig();
        fadeStep = COUNTS_PER_DIGIT / current_config.fadeSteps;
        break;
      }
    case MODE_DISPLAY_SCROLL_STEPS_DOWN: {
        if (button1.isButtonPressedAndReleased()) {
          current_config.scrollSteps--;
          if (current_config.scrollSteps < SCROLL_STEPS_MIN) {
            current_config.scrollSteps = SCROLL_STEPS_MAX;
          }
        }
        loadNumberArrayConfInt(current_config.scrollSteps, displayMode);
        displayConfig();
        break;
      }
    case MODE_DISPLAY_SCROLL_STEPS_UP: {
        if (button1.isButtonPressedAndReleased()) {
          current_config.scrollSteps++;
          if (current_config.scrollSteps > SCROLL_STEPS_MAX) {
            current_config.scrollSteps = SCROLL_STEPS_MIN;
          }
        }
        loadNumberArrayConfInt(current_config.scrollSteps, displayMode);
        displayConfig();
        break;
      }
    case MODE_PIR_TIMEOUT_DOWN: {
        if (button1.isButtonPressedAndReleased()) {
          current_config.pirTimeout -= 10;
          if (current_config.pirTimeout < PIR_TIMEOUT_MIN) {
            current_config.pirTimeout = PIR_TIMEOUT_MAX;
          }
        }
        loadNumberArrayConfIntWide(current_config.pirTimeout);
        allBright();
        break;
      }
    case MODE_PIR_TIMEOUT_UP: {
        if (button1.isButtonPressedAndReleased()) {
          current_config.pirTimeout += 10;
          if (current_config.pirTimeout > PIR_TIMEOUT_MAX) {
            current_config.pirTimeout = PIR_TIMEOUT_MIN;
          }
        }
        loadNumberArrayConfIntWide(current_config.pirTimeout);
        allBright();
        break;
      }
    case MODE_SLOTS_MODE: {
        if (button1.isButtonPressedAndReleased()) {
          current_config.slotsMode++;
          if (current_config.slotsMode > SLOTS_MODE_MAX) {
            current_config.slotsMode = SLOTS_MODE_MIN;
          }
        }
        loadNumberArrayConfInt(current_config.slotsMode, displayMode);
        displayConfig();
        break;
      }
    case MODE_BACKLIGHT_MODE: {
        if (button1.isButtonPressedAndReleased()) {
          current_config.backlightMode++;
          if (current_config.backlightMode > BACKLIGHT_MAX) {
            current_config.backlightMode = BACKLIGHT_MIN;
          }
        }
        loadNumberArrayConfInt(current_config.backlightMode, displayMode);
        displayConfig();
        break;
      }
    case MODE_RED_CNL: {
        if (button1.isButtonPressedAndReleased()) {
          current_config.redCnl++;
          if (current_config.redCnl > COLOUR_CNL_MAX) {
            current_config.redCnl = COLOUR_CNL_MIN;
          }
        }
        loadNumberArrayConfInt(current_config.redCnl, displayMode);
        displayConfig();
        break;
      }
    case MODE_GRN_CNL: {
        if (button1.isButtonPressedAndReleased()) {
          current_config.grnCnl++;
          if (current_config.grnCnl > COLOUR_CNL_MAX) {
            current_config.grnCnl = COLOUR_CNL_MIN;
          }
        }
        loadNumberArrayConfInt(current_config.grnCnl, displayMode);
        displayConfig();
        break;
      }
    case MODE_BLU_CNL: {
        if (button1.isButtonPressedAndReleased()) {
          current_config.bluCnl++;
          if (current_config.bluCnl > COLOUR_CNL_MAX) {
            current_config.bluCnl = COLOUR_CNL_MIN;
          }
        }
        loadNumberArrayConfInt(current_config.bluCnl, displayMode);
        displayConfig();
        break;
      }
    case MODE_CYCLE_SPEED: {
        if (button1.isButtonPressedAndReleased()) {
          current_config.cycleSpeed = current_config.cycleSpeed + 2;
          if (current_config.cycleSpeed > CYCLE_SPEED_MAX) {
            current_config.cycleSpeed = CYCLE_SPEED_MIN;
          }
        }
        loadNumberArrayConfInt(current_config.cycleSpeed, displayMode);
        displayConfig();
        break;
      }
    case MODE_MIN_DIM_UP: {
        if (button1.isButtonPressedAndReleased()) {
          current_config.minDim++;
          if (current_config.minDim > MIN_DIM_MAX) {
            current_config.minDim = MIN_DIM_MIN;
          }
        }
        loadNumberArrayConfInt(current_config.minDim, displayMode);
        displayConfig();
        break;
      }
    case MODE_MIN_DIM_DOWN: {
        if (button1.isButtonPressedAndReleased()) {
          current_config.minDim--;
          if (current_config.minDim < MIN_DIM_MIN) {
            current_config.minDim = MIN_DIM_MAX;
          }
        }
        loadNumberArrayConfInt(current_config.minDim, displayMode);
        displayConfig();
        break;
      }
    case MODE_USE_PIR_PULLUP: {
        if (button1.isButtonPressedAndReleased()) {
          current_config.usePIRPullup = !current_config.usePIRPullup;
        }
        loadNumberArrayConfBool(current_config.usePIRPullup, displayMode);
        digitalWrite(pirPin, current_config.usePIRPullup);
        displayConfig();
        break;
      }
    case MODE_LED_BLINK: {
        if (button1.isButtonPressedAndReleased()) {
          current_config.ledMode += 1;
          if (current_config.ledMode > LED_MODE_MAX) {
            current_config.ledMode = LED_MODE_MIN;
          }
        }
        loadNumberArrayConfInt(current_config.ledMode, displayMode);
        displayConfig();
        break;
      }
    case MODE_USE_PULSE: {
        if (button1.isButtonPressedAndReleased()) {
          current_config.useBLPulse = !current_config.useBLPulse;
        }
        loadNumberArrayConfBool(current_config.useBLPulse, displayMode);
        displayConfig();
        break;
      }
    case MODE_USE_DIM: {
        if (button1.isButtonPressedAndReleased()) {
          current_config.useBLDim = !current_config.useBLDim;
        }
        loadNumberArrayConfBool(current_config.useBLDim, displayMode);
        displayConfig();
        break;
      }
    case MODE_VERSION: {
        loadNumberArrayConfInt(SOFTWARE_VERSION, displayMode);
        displayConfig();
        break;
      }
    case MODE_TUBE_TEST: {
        allNormal();
        loadNumberArrayTestDigits();
        break;
      }
  }
}

//**********************************************************************************
//**********************************************************************************
//*                             Utility functions                                  *
//**********************************************************************************
//**********************************************************************************

// ************************************************************
// Break the time into displayable digits
// ************************************************************
void loadNumberArrayTime() {
  numberArray[3] = minute() % 10;
  numberArray[2] = minute() / 10;
  if (current_config.hourMode) {
    numberArray[1] = hourFormat12() % 10;
    numberArray[0] = hourFormat12() / 10;
  } else {
    numberArray[1] = hour() % 10;
    numberArray[0] = hour() / 10;
  }
}

// ************************************************************
// Break the minutes and seconds into displayable digits
// ************************************************************
void loadNumberArrayMinsSecs() {
  numberArray[3] = second() % 10;
  numberArray[2] = second() / 10;
  numberArray[1] = minute() % 10;
  numberArray[0] = minute() / 10;
}

// ************************************************************
// Break the date into displayable digits, respecting date format
// ************************************************************
void loadNumberArrayDayMonth() {
  switch (current_config.dateFormat) {
    case DATE_FORMAT_MMDD:
      numberArray[3] = day() % 10;
      numberArray[2] = day() / 10;
      numberArray[1] = month() % 10;
      numberArray[0] = month() / 10;
      break;
    case DATE_FORMAT_DDMM:
      numberArray[3] = month() % 10;
      numberArray[2] = month() / 10;
      numberArray[1] = day() % 10;
      numberArray[0] = day() / 10;
      break;
  }
}

// ************************************************************
// Break the year into displayable digits
// ************************************************************
void loadNumberArrayYear() {
  numberArray[3] = (year() / 1) % 10;
  numberArray[2] = (year() / 10) % 10;
  numberArray[1] = (year() / 100) % 10;
  numberArray[0] = (year() / 1000) % 10;
}

// ************************************************************
// Break the LDR reading into displayable digits
// ************************************************************
void loadNumberArrayLDR() {
  numberArray[3] = (ldrValue / 1) % 10;
  numberArray[2] = (ldrValue / 10) % 10;
  numberArray[1] = (ldrValue / 100) % 10;
  numberArray[0] = (ldrValue / 1000) % 10;
}

// ************************************************************
// Test digits
// ************************************************************
void loadNumberArrayTestDigits() {
  numberArray[3] = second() % 10;
  numberArray[2] = second() % 10;
  numberArray[1] = second() % 10;
  numberArray[0] = second() % 10;
}

// ************************************************************
// Show an integer configuration value
// ************************************************************
void loadNumberArrayConfInt(int confValue, byte mode) {
  numberArray[3] = (confValue / 1) % 10;
  numberArray[2] = (confValue / 10) % 10;
  numberArray[1] = mode % 10;
  numberArray[0] = mode / 10;
}

// ************************************************************
// Show an integer configuration value, use all 4 digits
// ************************************************************
void loadNumberArrayConfIntWide(int confValue) {
  numberArray[3] = (confValue / 1) % 10;
  numberArray[2] = (confValue / 10) % 10;
  numberArray[1] = (confValue / 100) % 10;
  numberArray[0] = (confValue / 1000) % 10;
}

// ************************************************************
// Show an configuration mode value
// ************************************************************
void loadNumberArrayConfMode(byte mode) {
  numberArray[3] = 0;
  numberArray[2] = 0;
  numberArray[1] = (mode / 1) % 10;
  numberArray[0] = (mode / 10) % 10;
}

// ************************************************************
// Show a boolean configuration value
// ************************************************************
void loadNumberArrayConfBool(boolean confValue, byte mode) {
  int boolInt;
  if (confValue) {
    boolInt = 1;
  } else {
    boolInt = 0;
  }
  numberArray[3] = boolInt;
  numberArray[2] = 0;
  numberArray[1] = mode % 10;
  numberArray[0] = mode / 10;
}

// ************************************************************
// Show an 1/4 IP configuration value
// ************************************************************
void loadNumberArrayIP(byte byte1) {
  numberArray[3] = (byte1) % 10;
  numberArray[2] = (byte1 / 10) % 10;
  numberArray[1] = (byte1 / 100) % 10;
  numberArray[0] = 0;
}

// ************************************************************
// Show the same value on all digits
// ************************************************************
void loadNumberArraySameValue(byte val) {
  numberArray[3] = val;
  numberArray[2] = val;
  numberArray[1] = val;
  numberArray[0] = val;
}

// ************************************************************
// Display preset
// ************************************************************
void loadDisplaySetValueType() {
  displayType[0] = valueDisplayType[0] >> 4;
  displayType[1] = valueDisplayType[0] & 0xf;
  displayType[2] = valueDisplayType[1] >> 4;
  displayType[3] = valueDisplayType[1] & 0xf;
}

// ************************************************************
// Display preset - used for Power On Self Test
// ************************************************************
void loadNumberArrayPOSTMessage(int postValue) {
  loadNumberArrayConfIntWide(postValue);

  // Load manually into the display buffer - the display loop is not working yet
  for (int i = 0 ; i < DIGIT_COUNT ; i++) {
    setDigit(i, numberArray[i], currNumberArray[i], COUNTS_PER_DIGIT, 0, false);
  }
}

// ************************************************************
// Prepare a single complete display, including any fading and
// dimming requested. Schedules the display into the digit
// Buffer which will be processed by the interrupt routine
// ************************************************************
void outputDisplay() {
  int tmpDispType;

  for ( int i = 0 ; i < DIGIT_COUNT ; i ++ ) {
    tmpDispType = displayType[i]; 
    if (blankTubes) {
      tmpDispType = BLANKED;
    } else if ((numberArray[i] != currNumberArray[i]) && !transition.isMessageOnDisplay(nowMillis)) {
      if ((numberArray[i] == 0) && current_config.scrollback) {
        tmpDispType = SCROLL;
      } else if (current_config.fade) {
        tmpDispType = FADE;
      }
    }

    // --------------------- Scroll ---------------------

    // manage scrolling, each impression we show 1 fade step less of the old
    // digit and 1 fade step more of the new. We hold the 
    if (tmpDispType == SCROLL) {
      if (numberArray[i] != currNumberArray[i]) {
        if (fadeState[i] == 0) {
          // Start the scroll step
          fadeState[i] = current_config.scrollSteps;
        }

        if (fadeState[i] == 1) {
          // finish the scroll step
          fadeState[i] = 0;
          currNumberArray[i] = currNumberArray[i] - 1;
        } else if (fadeState[i] > 1) {
          // Continue the scroll countdown
          fadeState[i] = fadeState[i] - 1;
        }
      }
    } else

    // --------------------- Fade ---------------------

    // manage fading, each step we show 1 fade step less of the old
    // digit and 1 fade step more of the new
    if (tmpDispType == FADE) {
      if (numberArray[i] != currNumberArray[i]) {
        // Start the fade
        if (fadeState[i] == 0) {
          fadeState[i] = current_config.fadeSteps;
          // debugMsg("Start Fade");
        }
      }

      if (fadeState[i] == 1) {
        // finish the fade
        fadeState[i] = 0;
        currNumberArray[i] = numberArray[i];
      } else if (fadeState[i] > 1) {
        // Continue the fade
        fadeState[i] = fadeState[i] - 1;
      }
    }

    switch (tmpDispType) {
      case BLANKED:
        {
          setDigit(i, numberArray[i], currNumberArray[i], COUNTS_PER_DIGIT, 0, true);
          break;
        }
      case DIMMED:
        {
          setDigit(i, numberArray[i], currNumberArray[i], COUNTS_PER_DIGIT_DIM, 0, false);
          break;
        }
      case BRIGHT:
        {
          setDigit(i, numberArray[i], currNumberArray[i], COUNTS_PER_DIGIT, 0, false);
          break;
        }
      case NORMAL:
        {
          setDigit(i, numberArray[i], currNumberArray[i], ldrValue, 0, false);
          break;
        }
      case FADE:
        {
          byte switchTime = getSwitchTime(ldrValue, fadeState[i], current_config.fadeSteps);
          setDigit(i, numberArray[i], currNumberArray[i], ldrValue, switchTime, false);
          break;
        }
      case SCROLL:
        {
          // Set the Switch state to 1 to show the previous digit
          setDigit(i, numberArray[i], currNumberArray[i], ldrValue, 1, false);
          break;
        }
      case BLINK:
        {
          if (blinkState) {
            setDigit(i, numberArray[i], currNumberArray[i], ldrValue, 0, false);
          } else {
            setDigit(i, numberArray[i], currNumberArray[i], COUNTS_PER_DIGIT, 0, true);
          }
          break;
        }
    }
  }
}

// ************************************************************
// Calculate the off time for this digit
// fadeSteps: The number of iterations we should fade over
// fadeState: the current step from 0 to fadeState-1
// result: 1..offCount
// ************************************************************
byte getSwitchTime(byte offCount, byte fadeState, byte fadeSteps) {
  float digitSwitchTimeFloat;
  digitSwitchTimeFloat = (float) offCount * (float) (fadeSteps - fadeState) / (float) fadeSteps;
  byte result = (byte) digitSwitchTimeFloat;

  // can't give back 0, because that means ("show new")
  if (result == 0) result = 1;
  // debugMsg("fadeState: " + String(fadeState) + ", result: " + result);
  return result;
}

// ************************************************************
// Turn the separator LEDs on
// ************************************************************
ICACHE_RAM_ATTR void ledsOn() {
  digitalWrite(LEDPin1, led1State);
  digitalWrite(LEDPin2, led2State);
}

// ************************************************************
// Turn the separator LEDs off
// ************************************************************
ICACHE_RAM_ATTR void ledsOff() {
  digitalWrite(LEDPin1, LOW);
  digitalWrite(LEDPin2, LOW);
}

// ************************************************************
// Display preset - apply leading zero blanking
// ************************************************************
void applyBlanking() {
  // If we are not blanking, just get out
  if (current_config.blankLeading == false) {
    return;
  }

  // We only want to blank the hours tens digit
  if (numberArray[0] == 0) {
    if (displayType[0] != BLANKED) {
      displayType[0] = BLANKED;
    }
  }
}

// ************************************************************
// Display preset
// ************************************************************
void allNormal(boolean blanking) {
  allNormal();

  if (blanking) {
    applyBlanking();
  }
}

// ************************************************************
// Display preset
// ************************************************************
void allBright() {
  displayType[0] = BRIGHT;
  displayType[1] = BRIGHT;
  displayType[2] = BRIGHT;
  displayType[3] = BRIGHT;
}

// ************************************************************
// highlight months taking into account the date format
// ************************************************************
void highlightMonthsDateFormat() {
  switch (current_config.dateFormat) {
    case DATE_FORMAT_MMDD:
      highlight0and1();
      break;
    case DATE_FORMAT_DDMM:
      highlight2and3();
      break;
  }
}

// ************************************************************
// highlight days taking into account the date format
// ************************************************************
void highlightDaysDateFormat() {
  switch (current_config.dateFormat) {
    case DATE_FORMAT_DDMM:
      highlight0and1();
      break;
    case DATE_FORMAT_MMDD:
      highlight2and3();
      break;
  }
}

// ************************************************************
// Display preset, highlight digits 0 and 1
// ************************************************************
void highlight0and1() {
  displayType[0] = BRIGHT;
  displayType[1] = BRIGHT;
  displayType[2] = DIMMED;
  displayType[3] = DIMMED;
}

// ************************************************************
// Display preset, highlight digits 2 and 3
// ************************************************************
void highlight2and3() {
  displayType[0] = DIMMED;
  displayType[1] = DIMMED;
  displayType[2] = BRIGHT;
  displayType[3] = BRIGHT;
}

// ************************************************************
// Display preset
// ************************************************************
void allNormal() {
  displayType[0] = NORMAL;
  displayType[1] = NORMAL;
  displayType[2] = NORMAL;
  displayType[3] = NORMAL;
}

// ************************************************************
// Display preset
// ************************************************************
void displayConfig() {
  displayType[0] = BLINK;
  displayType[1] = BLINK;
  displayType[2] = BRIGHT;
  displayType[3] = BRIGHT;
}

// ************************************************************
// Display preset
// ************************************************************
void displayConfigWide() {
  displayType[0] = BLINK;
  displayType[1] = BLINK;
  displayType[2] = BLANKED;
  displayType[3] = BLANKED;
}

// ************************************************************
// Display preset
// ************************************************************
void displayConfig3() {
  displayType[0] = BLANKED;
  displayType[1] = BRIGHT;
  displayType[2] = BRIGHT;
  displayType[3] = BRIGHT;
}

// ************************************************************
// Display preset
// ************************************************************
void displayConfig2() {
  displayType[0] = BLANKED;
  displayType[1] = BLANKED;
  displayType[2] = BRIGHT;
  displayType[3] = BRIGHT;
}

// ************************************************************
// Display preset
// ************************************************************
void allBlanked() {
  displayType[0] = BLANKED;
  displayType[1] = BLANKED;
  displayType[2] = BLANKED;
  displayType[3] = BLANKED;
}

// ************************************************************
// Display preset
// ************************************************************
void confBlink() {
  displayType[0] = BLINK;
  displayType[1] = BLINK;
  displayType[2] = BLINK;
  displayType[3] = BLINK;
}

// ************************************************************
// Display preset
// ************************************************************
void showDisplayIP() {
  displayType[0] = BLANKED;
  displayType[1] = NORMAL;
  displayType[2] = NORMAL;
  displayType[3] = NORMAL;
}

// ************************************************************
// Reset the seconds to 00
// ************************************************************
void resetSecond() {
  byte tmpSecs = 0;
  setTime(hour(), minute(), tmpSecs, day(), month(), year());
  setRTCTime();
}

// ************************************************************
// increment the time by 1 Sec
// ************************************************************
void incSecond() {
  byte tmpSecs = second();
  tmpSecs++;
  if (tmpSecs >= SECS_MAX) {
    tmpSecs = 0;
  }
  setTime(hour(), minute(), tmpSecs, day(), month(), year());
  setRTCTime();
}

// ************************************************************
// increment the time by 1 min
// ************************************************************
void incMins() {
  byte tmpMins = minute();
  tmpMins++;
  if (tmpMins >= MINS_MAX) {
    tmpMins = 0;
  }
  setTime(hour(), tmpMins, 0, day(), month(), year());
  setRTCTime();
}

// ************************************************************
// increment the time by 1 hour
// ************************************************************
void incHours() {
  byte tmpHours = hour();
  tmpHours++;

  if (tmpHours >= HOURS_MAX) {
    tmpHours = 0;
  }
  setTime(tmpHours, minute(), second(), day(), month(), year());
  setRTCTime();
}

// ************************************************************
// increment the date by 1 day
// ************************************************************
void incDays() {
  byte tmpDays = day();
  tmpDays++;

  int maxDays;
  switch (month())
  {
    case 4:
    case 6:
    case 9:
    case 11:
      {
        maxDays = 31;
        break;
      }
    case 2:
      {
        // we won't worry about leap years!!!
        maxDays = 28;
        break;
      }
    default:
      {
        maxDays = 31;
      }
  }

  if (tmpDays > maxDays) {
    tmpDays = 1;
  }
  setTime(hour(), minute(), second(), tmpDays, month(), year());
  setRTCTime();
}

// ************************************************************
// increment the month by 1 month
// ************************************************************
void incMonths() {
  byte tmpMonths = month();
  tmpMonths++;

  if (tmpMonths > 12) {
    tmpMonths = 1;
  }
  setTime(hour(), minute(), second(), day(), tmpMonths, year());
  setRTCTime();
}

// ************************************************************
// increment the year by 1 year
// ************************************************************
void incYears() {
  byte tmpYears = year() % 100;
  tmpYears++;

  if (tmpYears > 50) {
    tmpYears = 15;
  }
  setTime(hour(), minute(), second(), day(), month(), 2000 + tmpYears);
  setRTCTime();
}

// ************************************************************
// Set the time from the value we get back from the timer server
// ************************************************************
void setTimeFromServer(String timeString) {
  int intValues[6];
  grabInts(timeString, &intValues[0], ",");
  setTime(intValues[SYNC_HOURS], intValues[SYNC_MINS], intValues[SYNC_SECS], intValues[SYNC_DAY], intValues[SYNC_MONTH], intValues[SYNC_YEAR]);
  debugMsg("Set internal time to NTP time: " + String(year()) + ":" + String(month()) + ":" + String(day()) + " " + String(hour()) + ":" + String(minute()) + ":" + String(second()));
}


// ************************************************************
// Check the blanking, overridden if we have a PIR installed
// ************************************************************
boolean checkBlanking() {
  // If we are running on PIR, never use native blanking
  if (checkPIRInstalled())
    return false;

  // Check day blanking, but only when we are in
  // normal time mode
  if (currentMode == MODE_TIME) {
    switch (current_config.dayBlanking) {
      case DAY_BLANKING_NEVER:
        return false;
      case DAY_BLANKING_HOURS:
        return getHoursBlanked();
      case DAY_BLANKING_WEEKEND:
        return ((weekday() == 1) || (weekday() == 7));
      case DAY_BLANKING_WEEKEND_OR_HOURS:
        return ((weekday() == 1) || (weekday() == 7)) || getHoursBlanked();
      case DAY_BLANKING_WEEKEND_AND_HOURS:
        return ((weekday() == 1) || (weekday() == 7)) && getHoursBlanked();
      case DAY_BLANKING_WEEKDAY:
        return ((weekday() > 1) && (weekday() < 7));
      case DAY_BLANKING_WEEKDAY_OR_HOURS:
        return ((weekday() > 1) && (weekday() < 7)) || getHoursBlanked();
      case DAY_BLANKING_WEEKDAY_AND_HOURS:
        return ((weekday() > 1) && (weekday() < 7)) && getHoursBlanked();
      case DAY_BLANKING_ALWAYS:
        return true;
    }
  }

  // Not in time mode, or an unrecognised blanking setting: show the display.
  return false;
}

// ************************************************************
// Get the readable version of the PIR state
// ************************************************************
String getPIRStateDisplay() {
  float lastMotionDetection = (nowMillis - pirLastSeen) / 1000.0;

  String part3 = " ago";
  if (blanked) {
    part3 = " ago (blanked)";
  }
  return "Motion detected " + secsToReadableString(lastMotionDetection) + part3;
}

// ************************************************************
// If we are currently blanked based on hours
// ************************************************************
boolean getHoursBlanked() {
  if (current_config.blankHourStart > current_config.blankHourEnd) {
    // blanking before midnight
    return ((hour() >= current_config.blankHourStart) || (hour() < current_config.blankHourEnd));
  } else if (current_config.blankHourStart < current_config.blankHourEnd) {
    // dim at or after midnight
    return ((hour() >= current_config.blankHourStart) && (hour() < current_config.blankHourEnd));
  } else {
    // no dimming if Start = End
    return false;
  }
}

// ************************************************************
// Set the tubes and LEDs blanking variables based on blanking mode and
// blank mode settings
// ************************************************************
void setTubesAndLEDSBlankMode() {
  if (blanked) {
    switch (current_config.blankMode) {
      case BLANK_MODE_TUBES:
        {
          blankTubes = true;
          blankLEDs = false;
          blankSeparators = false;
          break;
        }
      case BLANK_MODE_LEDS:
        {
          blankTubes = false;
          blankLEDs = true;
          blankSeparators = false;
          break;
        }
      case BLANK_MODE_BOTH:
        {
          blankTubes = true;
          blankLEDs = true;
          blankSeparators = false;
          break;
        }
      case BLANK_MODE_ALL:
        {
          blankTubes = true;
          blankLEDs = true;
          blankSeparators = true;
          break;
        }
    }
  } else {
    blankTubes = false;
    blankLEDs = false;
    blankSeparators = false;
  }

  ledManager.setBlanked(blankLEDs);
}

// ************************************************************
// Set the diagnostic LED colour:
// state: 0 = red, 1 = orange, 2 = green, 3 = blue
// ************************************************************
void setDiagnosticLED(byte stepNumber, byte state) {
  ledManager.setDiagnosticLED(stepNumber, state);
  delay(500);
}

void setPIRPullup(boolean newState) {
  if (newState) {
    debugMsg("Setting PIR pullup");
    pinMode(pirPin, INPUT_PULLUP);
  } else {
    debugMsg("Resetting PIR pullup");
    pinMode(pirPin, INPUT);
  }
}

// ************************************************************
// Jump to a new position in the menu - used to skip unused items
// ************************************************************
void setNewNextMode(int newNextMode) {
  nextMode = newNextMode;
  currentMode = newNextMode - 1;
}

// ************************************************************
// Callback: When the NTP component tells us there is an update
// go and get it
// ************************************************************
void newTimeUpdateReceived() {
  debugMsg("Got a new time update");
  setTimeFromServer(ntpAsync.getLastTimeFromServer());
  setRTCTime();
}

//**********************************************************************************
//**********************************************************************************
//*                         RTC Module Time Provider                               *
//**********************************************************************************
//**********************************************************************************

// ************************************************************
// Get the time from the RTC
// ************************************************************
String getRTCTime(boolean setInternalTime) {
  testRTCTimeProvider();
  if (useRTC) {
    Clock.getTime();
    int years = Clock.year + 2000;
    byte months = Clock.month;
    byte days = Clock.dayOfMonth;
    byte hours = Clock.hour;
    byte mins = Clock.minute;
    byte secs = Clock.second;

    String returnValue = String(years) + ":" + String(months) + ":" + String(days) + " " + String(hours) + ":" + String(mins) + ":" + String(secs);
    debugMsg("Got RTC time: " + returnValue);

    if (setInternalTime) {
      // Set the internal time provider to the value we got
      setTime(hours, mins, secs, days, months, years);
      debugMsg("Set Internal time to: " + returnValue);
    }

    return returnValue;
  }

  // No RTC fitted. The only caller that uses the result guards on useRTC.
  return "";
}

// ************************************************************
// Check that we still have access to the time from the RTC
// ************************************************************
void testRTCTimeProvider() {
  // Set up the time provider
  // first try to find the RTC, if not available, go into slave mode
  Wire.beginTransmission(RTC_I2C_ADDRESS);
  useRTC = (Wire.endTransmission() == 0);
}

// ************************************************************
// Set the date/time in the RTC from the internal time
// Always hold the time in 24 format, we convert to 12 in the
// display.
// ************************************************************
void setRTCTime() {
  testRTCTimeProvider();
  if (useRTC) {
    Clock.fillByYMD(year() % 100, month(), day());
    Clock.fillByHMS(hour(), minute(), second());
    Clock.setTime();

    debugMsg("Set RTC time to internal time: " + String(year()) + ":" + String(month()) + ":" + String(day()) + " " + String(hour()) + ":" + String(minute()) + ":" + String(second()));
  }
}

//**********************************************************************************
//**********************************************************************************
//*                          Light Dependent Resistor                              *
//**********************************************************************************
//**********************************************************************************

// ******************************************************************
// Check the ambient light through the LDR (Light Dependent Resistor)
// Smooths the reading over a number of reads.
//
// The LDR in bright light gives reading of around 50, the reading in
// total darkness is around 900.
//
// The return value is the dimming count we are using. 999 is full
// brightness, 100 is very dim.
//
// Because the floating point calculation may return more than the
// maximum value, we have to clamp it as the final step
// ******************************************************************
int getDimmingFromLDR() {
  if (current_config.useLDR) {
    int rawLDR = analogRead(LDRPin);
    int rawSensorVal = 1023 - rawLDR;

    double sensorDiff = rawSensorVal - sensorLDRSmoothed;
    sensorLDRSmoothed += (sensorDiff / (double)current_config.sensorSmoothCountLDR);

    // Scaling offset increases the base brightness
    // factor increases the sensitivity
    double offset = current_config.thresholdBright;
    double factor = current_config.sensitivityLDR / 5.0;

    int returnValue = (sensorLDRSmoothed + offset) / factor;

    if (returnValue < current_config.minDim) returnValue = current_config.minDim;
    if (returnValue > COUNTS_PER_DIGIT) returnValue = COUNTS_PER_DIGIT;
    return returnValue;
  } else {
    return COUNTS_PER_DIGIT;
  }
}

// ************************************************************
// Reset configuration values back to what they once were
// ************************************************************
void factoryReset() {
  ntpAsync.resetDefaults();
  spiffs_config_t* cc = &current_config;
  cc->ntpPool = ntpAsync.getNtpPool();
  cc->ntpUpdateInterval = ntpAsync.getUpdateInterval();
  cc->tzs = ntpAsync.getTZS();

  cc->hourMode = HOUR_MODE_DEFAULT;
  cc->minDim = MIN_DIM_DEFAULT;
  cc->fade = false;
  cc->scrollback = false;
  cc->fadeSteps = FADE_STEPS_DEFAULT;
  cc->scrollSteps = SCROLL_STEPS_DEFAULT;

  cc->thresholdBright = SENSOR_THRSH_DEFAULT;
  cc->sensorSmoothCountLDR = SENSOR_SMOOTH_READINGS_DEFAULT;
  cc->sensitivityLDR = SENSOR_SENSIT_DEFAULT;

  cc->blankHourStart = 0;
  cc->blankHourEnd = 7;
  
  cc->dateFormat = DATE_FORMAT_DEFAULT;
  cc->dayBlanking = DAY_BLANKING_DEFAULT;
  cc->blankMode = BLANK_MODE_DEFAULT;

  cc->useLDR = USE_LDR_DEFAULT;
  cc->pirTimeout = PIR_TIMEOUT_DEFAULT;
  cc->usePIRPullup = USE_PIR_PULLUP_DEFAULT;
  
  cc->backlightMode = BACKLIGHT_DEFAULT;
  cc->useBLPulse = false;
  cc->useBLDim = true;
  cc->redCnl = COLOUR_RED_CNL_DEFAULT;
  cc->grnCnl = COLOUR_GRN_CNL_DEFAULT;
  cc->bluCnl = COLOUR_BLU_CNL_DEFAULT;
  cc->cycleSpeed = CYCLE_SPEED_DEFAULT;
  
  cc->slotsMode = SLOTS_MODE_DEFAULT;
  cc->blankLeading = LEAD_BLANK_DEFAULT;
  
  cc->dateFormat = DATE_FORMAT_DEFAULT;
  cc->ledMode = LED_BLINK_DEFAULT;
  cc->statusModeL = STATUS_LED_MODE_ONLINE;
  cc->statusModeR = STATUS_LED_MODE_NTP;
  cc->backlightDimFactor = BACKLIGHT_DIM_FACTOR_DEFAULT;
  
  cc->testMode = true;
  
  setWebAuthentication(WEB_AUTH_DEFAULT);
  cc->webAuthentication = getWebAuthentication();
  setWebUserName(WEB_USERNAME_DEFAULT);
  cc->webUsername = getWebUserName();
  setWebPassword(WEB_PASSWORD_DEFAULT);
  cc->webPassword = getWebPassword();

  cc->preheatStrength = 0;
  cc->extDimFactor = EXT_DIM_FACTOR_DEFAULT;
  cc->separatorDimFactor = SEP_DIM_DEFAULT;

  cc->doNotDimIndLEDs = false;
  cc->antiGhost = ANTI_GHOST_DEFAULT;

  spiffs.saveConfigToSpiffs(cc);
}

void saveToSpiffsIfChanged(boolean changed) {
  if (changed) {
    debugMsg("Config options changed, saving them");
    spiffs.saveConfigToSpiffs(&current_config);

    // Save the stats while we are at it
    spiffs.saveStatsToSpiffs(&current_stats);
  }
}

//**********************************************************************************
//**********************************************************************************
//*                                Page Handlers                                   *
//**********************************************************************************
//**********************************************************************************

// ************************************************************
// Summary page
// ************************************************************
void rootPageHandler() {
  debugMsg("Root page in");

  String response_message = getHTMLHead(getIsConnected());
  response_message += getNavBar();

  // Status table
  response_message += getTableHead2Col("Current Status", "Name", "Value");

  if (WiFi.status() == WL_CONNECTED)
  {
    IPAddress ip = WiFi.localIP();
    response_message += getTableRow2Col("WLAN IP", formatIPAsString(ip));
    response_message += getTableRow2Col("WLAN MAC", WiFi.macAddress());
    response_message += getTableRow2Col("WLAN SSID", WiFi.SSID());
    response_message += getTableRow2Col("NTP Pool", ntpAsync.getNtpPool());
    response_message += getTableRow2Col("TZ", ntpAsync.getTZS());
    response_message += getTableRow2Col("Last NTP time", ntpAsync.getLastTimeFromServer());
    response_message += getTableRow2Col("Clock Name", WiFi.hostname());
  }
  else
  {
    IPAddress softapip = WiFi.softAPIP();
    String ipStrAP = String(softapip[0]) + '.' + String(softapip[1]) + '.' + String(softapip[2]) + '.' + String(softapip[3]);
    response_message += getTableRow2Col("AP IP", ipStrAP);
    response_message += getTableRow2Col("AP MAC", WiFi.softAPmacAddress());
  }

  response_message += getTableRow2Col("Uptime", secsToReadableString(millis() / 1000));

  long lastUpdateTimeSecs = ntpAsync.getLastUpdateTimeSecs(millis());
  response_message += getTableRow2Col("Last time update", secsToReadableString(lastUpdateTimeSecs) + " ago");

  signed long absNextUpdate = abs(ntpAsync.getNextUpdate(millis()));
  String overdueInd = "";
  if (absNextUpdate < 0) {
    overdueInd = " overdue";
    absNextUpdate = -absNextUpdate;
  }
  response_message += getTableRow2Col("Time before next update", secsToReadableString(absNextUpdate) + overdueInd);

  response_message += getTableRow2Col("Version", SOFTWARE_VERSION);

  // Scan I2C bus
  for (int idx = 0 ; idx < 128 ; idx++)
  {
    Wire.beginTransmission(idx);
    int error = Wire.endTransmission();
    if (error == 0) {
      String slaveMsg = "Found I2C slave at";
      response_message += getTableRow2Col(slaveMsg, idx);
    }
  }

  response_message += getTableFoot();

  // ******************** Clock Info table ***************************
  float digitBrightnessPercent = getDimmingFromLDR() * 100.0 / (float) COUNTS_PER_DIGIT;
  String motionSensorState = checkPIRInstalled() ? getPIRStateDisplay() : "Not installed";
  String rtcState = useRTC ? "Installed" : "Not installed";
  String timeSource;

  if (ntpAsync.ntpTimeValid(nowMillis)) {
    timeSource = "NTP";
  } else if (useRTC) {
    timeSource = "RTC";
  } else {
    timeSource = "Internal";
  }
  String currentTime = String(year()) + ":" + String(month()) + ":" + String(day()) + " " + String(hour()) + ":" + String(minute()) + ":" + String(second());
  response_message += getTableHead2Col("Clock information", "Name", "Value");

  if (current_config.useLDR) {
    response_message += getTableRow2Col("LDR Value", sensorLDRSmoothed);
  } else {
    response_message += getTableRow2Col("LDR Value", "LDR disabled");
  }

  response_message += getTableRow2Col("Digit brightness %", String(digitBrightnessPercent, 2));
  response_message += getTableRow2Col("Motion Sensor", motionSensorState);
  response_message += getTableRow2Col("Time Source", timeSource);
  response_message += getTableRow2Col("Display Time", currentTime);
  response_message += getTableRow2Col("Real Time Clock", rtcState);
  if (useRTC) {
    response_message += getTableRow2Col("RTC Time", getRTCTime(false));
  }
  response_message += getTableRow2Col("Impressions/Sec", lastImpressionsPerSec);
  response_message += getTableRow2Col("Total Clock On Hrs", secsToReadableString(uptimeMins * 60));
  response_message += getTableRow2Col("Total Tube On Hrs", secsToReadableString(tubeOnTimeMins * 60));
  response_message += getTableFoot();

  // ******************** ESP8266 Info table ***************************
  response_message += getTableHead2Col("ESP8266 information", "Name", "Value");
  response_message += getTableRow2Col("Sketch size", ESP.getSketchSize());
  response_message += getTableRow2Col("Free sketch size", ESP.getFreeSketchSpace());
  response_message += getTableRow2Col("Sketch hash", ESP.getSketchMD5());
  response_message += getTableRow2Col("Free heap", ESP.getFreeHeap());
  response_message += getTableRow2Col("Boot version", ESP.getBootVersion());
  response_message += getTableRow2Col("CPU Freqency (MHz)", ESP.getCpuFreqMHz());
  response_message += getTableRow2Col("Flash speed (MHz)", ESP.getFlashChipSpeed() / 1000000);
  response_message += getTableRow2Col("SDK version", ESP.getSdkVersion());
  response_message += getTableRow2Col("Chip ID", String(ESP.getChipId(), HEX));
  response_message += getTableRow2Col("Flash Chip ID", String(ESP.getFlashChipId(), HEX));
  response_message += getTableRow2Col("Flash size", ESP.getFlashChipRealSize());
  response_message += getTableFoot();

  response_message += getHTMLFoot();

  server.send(200, "text/html", response_message);

  debugMsg("Root page out");
}

// ************************************************************
// Manage the NTP Settings
// ************************************************************
void timeServerPageHandler() {
  debugMsg("Time page in");

  boolean changed = false;
  
  checkServerArgString("ntppool", "NTP Pool", changed, current_config.ntpPool);
  checkServerArgInt("ntpupdate", "NTP update interval", changed, current_config.ntpUpdateInterval);
  checkServerArgString("tzs", "Time Zone String", changed, current_config.tzs);
  if (changed) {
    ntpAsync.setTZS(current_config.tzs);
    ntpAsync.setNtpPool(current_config.ntpPool);
    ntpAsync.setUpdateInterval(current_config.ntpUpdateInterval);
  }
  saveToSpiffsIfChanged(changed);

  // -----------------------------------------------------------------------------

  String response_message = getHTMLHead(getIsConnected());
  response_message += getNavBar();

  // form header
  response_message += getFormHead("Select time server");

  debugMsg("ntpPool is: " + ntpAsync.getNtpPool());
  response_message += getTextInputWide("NTP Pool", "ntppool", ntpAsync.getNtpPool(), false);
  response_message += getNumberInput("Update interval:", "ntpupdate", NTP_UPDATE_INTERVAL_MIN, NTP_UPDATE_INTERVAL_MAX, ntpAsync.getUpdateInterval(), false);
  response_message += getTextInputWide("Time Zone String", "tzs", ntpAsync.getTZS(), false);

  response_message += getSubmitButton("Set");

  response_message += getFormFoot();
  response_message += getHTMLFoot();

  server.send(200, "text/html", response_message);

  debugMsg("Time page out");
}

// ************************************************************
// Reset the EEPROM and WiFi values, restart
// ************************************************************
void resetPageHandler() {
  debugMsg("Reset page in");

  WiFiManager wifiManager;
  wifiManager.resetSettings();
  factoryReset();

  String response_message = getHTMLHead(getIsConnected());
  response_message += getNavBar();

  response_message += "<div class=\"container\" role=\"main\"><h3 class=\"sub-header\">Send time to I2C right now</h3>";
  response_message += "<div class=\"alert alert-success fade in\"><strong>Success!</strong> Reset done.</div></div>";

  response_message += getHTMLFoot();

  server.send(200, "text/html", response_message);

  debugMsg("Reset page out");

  // let the message get written
  delay(500);

  // do the restart
  ESP.restart();
}

// ************************************************************
// Page for the clock configuration
// ************************************************************
void clockConfigPageHandler() {
  debugManager.debugMsg("Config page in");

  boolean changed = false;

  // -----------------------------------------------------------------------------
  checkServerArgBoolean("12h24hMode", "12/24h mode", "12h", "24h", changed, current_config.hourMode);
  checkServerArgBoolean("blankLeading", "Leading zero", "blank", "show", changed, current_config.blankLeading);
  checkServerArgByte("dateFormat", "dateFormat", changed, current_config.dateFormat);
  checkServerArgByte("slotsMode", "slotsMode", changed, current_config.slotsMode);
#ifdef FEATURE_PREHEAT
  checkServerArgByte("preheatStrength", "preheatStrength", changed, current_config.preheatStrength);
#endif
#ifdef FEATURE_SCROLL
  checkServerArgBoolean("scrollback", "Use scrollback", "on", "off", changed, current_config.scrollback);
  checkServerArgByte("scrollSteps", "scrollSteps", changed, current_config.scrollSteps);
#endif
#ifdef FEATURE_FADE
  checkServerArgBoolean("fade", "Use fade", "on", "off", changed, current_config.fade);
  checkServerArgByte("fadeSteps", "fadeSteps", changed, current_config.fadeSteps);
#endif
  // -----------------------------------------------------------------------------
  checkServerArgBoolean("useLDR", "Use LDR", "on", "off", changed, current_config.useLDR);
  checkServerArgInt("minDim", "minDim", changed, current_config.minDim);
  checkServerArgInt("thresholdBright", "thresholdBright", changed, current_config.thresholdBright);
  checkServerArgInt("sensitivityLDR", "sensitivityLDR", changed, current_config.sensitivityLDR);
  // -----------------------------------------------------------------------------
#ifdef FEATURE_PIR
  checkServerArgInt("pirTimeout", "pirTimeout", changed, current_config.pirTimeout);
  checkServerArgBoolean("usePIRPullup", "Use PIR pullup", "on", "off", changed, current_config.usePIRPullup);
#endif
  checkServerArgByte("dayBlanking", "dayBlanking", changed, current_config.dayBlanking);
  checkServerArgByte("blankMode", "blankMode", changed, current_config.blankMode);
  checkServerArgByte("blankHourStart", "blankHourStart", changed, current_config.blankHourStart);
  checkServerArgByte("blankHourEnd", "blankHourEnd", changed, current_config.blankHourEnd);
  // -----------------------------------------------------------------------------
  checkServerArgByte("backlightMode", "backlightMode", changed, current_config.backlightMode);
  checkServerArgByte("cycleSpeed", "cycleSpeed", changed, current_config.cycleSpeed);
  checkServerArgBoolean("useBLPulse", "Use BL pulse", "on", "off", changed, current_config.useBLPulse);
  checkServerArgBoolean("useBLDim", "Use BL dim", "on", "off", changed, current_config.useBLDim);
  // -----------------------------------------------------------------------------
  checkServerArgByte("redCnl", "redCnl", changed, current_config.redCnl);
  checkServerArgByte("grnCnl", "grnCnl", changed, current_config.grnCnl);
  checkServerArgByte("bluCnl", "bluCnl", changed, current_config.bluCnl);
  checkServerArgByte("backlightDimFactor", "backlightDimFactor", changed, current_config.backlightDimFactor);
#ifdef FEATURE_EXT_LEDS
  checkServerArgByte("extDimFactor", "extDimFactor", changed, current_config.extDimFactor);
#endif
  
  // -----------------------------------------------------------------------------
#ifdef FEATURE_LED_MODES
  checkServerArgByte("ledMode", "ledMode", changed, current_config.ledMode);
#endif

#ifdef FEATURE_STATUS_LEDS
  checkServerArgByte("statusModeL", "statusModeL", changed, current_config.statusModeL);
  checkServerArgByte("statusModeR", "statusModeR", changed, current_config.statusModeR);
#endif
  checkServerArgByte("separatorDimFactor", "separatorDimFactor", changed, current_config.separatorDimFactor);
  // -----------------------------------------------------------------------------
  boolean webConfigChanged = false;
  checkServerArgBoolean("webAuthentication", "Web Authentication", "on", "off", webConfigChanged, current_config.webAuthentication);
  checkServerArgString("webUsername", "webUsername", webConfigChanged, current_config.webUsername);
  checkServerArgString("webPassword", "webPassword", webConfigChanged, current_config.webPassword);
  if (webConfigChanged) {
    changed = true;
    setWebAuthentication(current_config.webAuthentication);
    setWebUserName(current_config.webUsername);
    setWebPassword(current_config.webPassword);
  }
  saveToSpiffsIfChanged(changed);
  
  ledManager.recalculateVariables();

  // -----------------------------------------------------------------------------
  String response_message = getHTMLHead(getIsConnected());
  response_message += getNavBar();

  // -----------------------------------------------------------------------------
  response_message += getFormHead("General options");

  // 12/24 mode
  response_message += getRadioGroupHeader("12H/24H mode:");
  if (current_config.hourMode) {
    response_message += getRadioButton("12h24hMode", " 12H", "12h", true);
    response_message += getRadioButton("12h24hMode", " 24H", "24h", false);
  } else {
    response_message += getRadioButton("12h24hMode", " 12H", "12h", false);
    response_message += getRadioButton("12h24hMode", " 24H", "24h", true);
  }
  response_message += getRadioGroupFooter();

  // blank leading
  response_message += getRadioGroupHeader("Blank leading zero:");
  if (current_config.blankLeading) {
    response_message += getRadioButton("blankLeading", "Blank", "blank", true);
    response_message += getRadioButton("blankLeading", "Show", "show", false);
  } else {
    response_message += getRadioButton("blankLeading", "Blank", "blank", false);
    response_message += getRadioButton("blankLeading", "Show", "show", true);
  }
  response_message += getRadioGroupFooter();

  // Date format
  response_message += getDropDownHeader("Date format:", "dateFormat", false, false);
  response_message += getDropDownOption("0", "MM-DD", (current_config.dateFormat == 0));
  response_message += getDropDownOption("1", "DD-MM", (current_config.dateFormat == 1));
  response_message += getDropDownFooter();

  // Slots Mode
  response_message += getDropDownHeader("Date Slots:", "slotsMode", true, false);
  response_message += getDropDownOption("0", "Don't use slots mode", (current_config.slotsMode == 0));
  response_message += getDropDownOption("1", "Scroll In, Scramble Out", (current_config.slotsMode == 1));
  response_message += getDropDownFooter();

#ifdef FEATURE_PREHEAT
  // preheat mode
  response_message += getDropDownHeader("Digit pre-heat:", "preheatStrength", true, false);
  response_message += getDropDownOption("1", "Very Strong", (current_config.preheatStrength == 1));
  response_message += getDropDownOption("2", "Strong", (current_config.preheatStrength == 2));
  response_message += getDropDownOption("3", "Weak", (current_config.preheatStrength == 3));
  response_message += getDropDownOption("4", "Very Weak", (current_config.preheatStrength == 4));
  response_message += getDropDownOption("5", "Off", (current_config.preheatStrength == 5));
  response_message += getDropDownFooter();
#endif

#ifdef FEATURE_SCROLL
  // Scrollback
  response_message += getRadioGroupHeader("Scrollback effect:");
  if (current_config.scrollback) {
    response_message += getRadioButton("scrollback", "On", "on", true);
    response_message += getRadioButton("scrollback", "Off", "off", false);
  } else {
    response_message += getRadioButton("scrollback", "On", "on", false);
    response_message += getRadioButton("scrollback", "Off", "off", true);
  }
  response_message += getRadioGroupFooter();

  // Scroll steps
  response_message += getNumberInput("Scroll steps:", "scrollSteps", SCROLL_STEPS_MIN, SCROLL_STEPS_MAX, current_config.scrollSteps, !current_config.scrollback);
#endif

#ifdef FEATURE_FADE
  // fade
  response_message += getRadioGroupHeader("Fade effect:");
  if (current_config.fade) {
    response_message += getRadioButton("fade", "On", "on", true);
    response_message += getRadioButton("fade", "Off", "off", false);
  } else {
    response_message += getRadioButton("fade", "On", "on", false);
    response_message += getRadioButton("fade", "Off", "off", true);
  }
  response_message += getRadioGroupFooter();

  // Fade steps
  response_message += getNumberInput("Fade steps:", "fadeSteps", FADE_STEPS_MIN, FADE_STEPS_MAX, current_config.fadeSteps, !current_config.fade);
#endif

  response_message += getSubmitButton("Set");

  response_message += getFormFoot();

  // -----------------------------------------------------------------------------
  response_message += getFormHead("Light Dependent Resistor");

  // LDR
  response_message += getRadioGroupHeader("Use LDR:");
  if (current_config.useLDR) {
    response_message += getRadioButton("useLDR", "On", "on", true);
    response_message += getRadioButton("useLDR", "Off", "off", false);
  } else {
    response_message += getRadioButton("useLDR", "On", "on", false);
    response_message += getRadioButton("useLDR", "Off", "off", true);
  }
  response_message += getRadioGroupFooter();

  // Min dim
  response_message += getNumberInput("Min Dim:", "minDim", MIN_DIM_MIN, MIN_DIM_MAX, current_config.minDim, false);

  // LDR threshold
  response_message += getNumberInput("LDR Threshold:", "thresholdBright", SENSOR_THRSH_MIN, SENSOR_THRSH_MAX, current_config.thresholdBright, false);

  // LDR Sensitivity
  response_message += getNumberInput("LDR Sensitivity:", "sensitivityLDR", SENSOR_SENSIT_MIN, SENSOR_SENSIT_MAX, current_config.sensitivityLDR, false);

  response_message += getSubmitButton("Set");

  response_message += getFormFoot();

  // -----------------------------------------------------------------------------
  response_message += getFormHead("Digit blanking");
  
#ifdef FEATURE_PIR
  if (pirInstalled) {
    response_message += getExplanationText("Motion detector installed - time based blanking is disabled");
  } else {
    response_message += getExplanationText("Motion detector not installed - motion detector blanking is inactive");
  }
  
  // PIR timeout
  response_message += getNumberInput("Motion timeout:", "pirTimeout", PIR_TIMEOUT_MIN, PIR_TIMEOUT_MAX, current_config.pirTimeout, !pirInstalled);

  // PIR pullup
  response_message += getRadioGroupHeader("Use Motion detector pullup:");
  if (current_config.usePIRPullup) {
    response_message += getRadioButton("usePIRPullup", "On", "on", true);
    response_message += getRadioButton("usePIRPullup", "Off", "off", false);
  } else {
    response_message += getRadioButton("usePIRPullup", "On", "on", false);
    response_message += getRadioButton("usePIRPullup", "Off", "off", true);
  }
  response_message += getRadioGroupFooter();
#endif

  // Day blanking
  response_message += getDropDownHeader("Day blanking:", "dayBlanking", true, pirInstalled);
  response_message += getDropDownOption("0", "Never blank", (current_config.dayBlanking == DAY_BLANKING_NEVER));
  response_message += getDropDownOption("1", "Blank all day on weekends", (current_config.dayBlanking == DAY_BLANKING_WEEKEND));
  response_message += getDropDownOption("2", "Blank all day on week days", (current_config.dayBlanking == DAY_BLANKING_WEEKDAY));
  response_message += getDropDownOption("3", "Blank always", (current_config.dayBlanking == DAY_BLANKING_ALWAYS));
  response_message += getDropDownOption("4", "Blank during selected hours every day", (current_config.dayBlanking == DAY_BLANKING_HOURS));
  response_message += getDropDownOption("5", "Blank during selected hours on week days and all day on weekends", (current_config.dayBlanking == DAY_BLANKING_WEEKEND_OR_HOURS));
  response_message += getDropDownOption("6", "Blank during selected hours on weekends and all day on week days", (current_config.dayBlanking == DAY_BLANKING_WEEKDAY_OR_HOURS));
  response_message += getDropDownOption("7", "Blank during selected hours on weekends only", (current_config.dayBlanking == DAY_BLANKING_WEEKEND_AND_HOURS));
  response_message += getDropDownOption("8", "Blank during selected hours on week days only", (current_config.dayBlanking == DAY_BLANKING_WEEKDAY_AND_HOURS));
  response_message += getDropDownFooter();

  // Blank Mode
  response_message += getDropDownHeader("Blank Mode:", "blankMode", true, false);
  response_message += getDropDownOption("0", "Blank tubes only", (current_config.blankMode == BLANK_MODE_TUBES));
  response_message += getDropDownOption("1", "Blank LEDs only", (current_config.blankMode == BLANK_MODE_LEDS));
  response_message += getDropDownOption("2", "Blank tubes and LEDs", (current_config.blankMode == BLANK_MODE_BOTH));
  response_message += getDropDownOption("3", "Blank everything", (current_config.blankMode == BLANK_MODE_ALL));
  response_message += getDropDownFooter();

  boolean hoursDisabled = (current_config.dayBlanking < 4) || pirInstalled;

  // Blank hours from
  response_message += getNumberInput("Blank from:", "blankHourStart", 0, 23, current_config.blankHourStart, hoursDisabled);

  // Blank hours to
  response_message += getNumberInput("Blank to:", "blankHourEnd", 0, 23, current_config.blankHourEnd, hoursDisabled);

  response_message += getSubmitButton("Set");

  response_message += getFormFoot();

  // -----------------------------------------------------------------------------
  response_message += getFormHead("Back/Underlights");

  // Back light
  response_message += getDropDownHeader("Back light:", "backlightMode", true, false);
  response_message += getDropDownOption("0", "Fixed RGB backlight", (current_config.backlightMode == BACKLIGHT_FIXED));
  response_message += getDropDownOption("1", "Cycling RGB backlight", (current_config.backlightMode == BACKLIGHT_CYCLE));
  response_message += getDropDownOption("2", "'Colourtime' backlight", (current_config.backlightMode == BACKLIGHT_COLOUR_TIME));
  response_message += getDropDownOption("3", "'Day of week' backlight", (current_config.backlightMode == BACKLIGHT_DAY_OF_WEEK));
  response_message += getDropDownFooter();

  // Cycle speed
  boolean activeCycle = (current_config.backlightMode == 1);
  response_message += getNumberInput("Backlight Cycle Speed:", "cycleSpeed", CYCLE_SPEED_MIN, CYCLE_SPEED_MAX, current_config.cycleSpeed, !activeCycle);

  // Dim backlights
  response_message += getRadioGroupHeader("Dim backlights:");
  if (current_config.useBLDim) {
    response_message += getRadioButton("useBLDim", "On", "on", true);
    response_message += getRadioButton("useBLDim", "Off", "off", false);
  } else {
    response_message += getRadioButton("useBLDim", "On", "on", false);
    response_message += getRadioButton("useBLDim", "Off", "off", true);
  }
  response_message += getRadioGroupFooter();

  // Pulse backlights
  response_message += getRadioGroupHeader("Pulse backlights:");
  if (current_config.useBLPulse) {
    response_message += getRadioButton("useBLPulse", "On", "on", true);
    response_message += getRadioButton("useBLPulse", "Off", "off", false);
  } else {
    response_message += getRadioButton("useBLPulse", "On", "on", false);
    response_message += getRadioButton("useBLPulse", "Off", "off", true);
  }
  response_message += getRadioGroupFooter();

  // RGB channels
  boolean activeLEDs = (current_config.backlightMode == 0);

  response_message += getNumberInput("Red intensity:", "redCnl", 0, 15, current_config.redCnl, !activeLEDs);
  response_message += getNumberInput("Green intensity:", "grnCnl", 0, 15, current_config.grnCnl, !activeLEDs);
  response_message += getNumberInput("Blue intensity:", "bluCnl", 0, 15, current_config.bluCnl, !activeLEDs);

  // backlight dim factor
  response_message += getNumberInput("Backlight Dim:", "backlightDimFactor", BACKLIGHT_DIM_FACTOR_MIN, BACKLIGHT_DIM_FACTOR_MAX, current_config.backlightDimFactor, false);

#ifdef FEATURE_EXT_LEDS
  // external backlight dim factor
  response_message += getNumberInput("Underlight Dim:", "extDimFactor", EXT_DIM_FACTOR_MIN, EXT_DIM_FACTOR_MAX, current_config.extDimFactor, false);
#endif

  response_message += getSubmitButton("Set");

  response_message += getFormFoot();

  // -----------------------------------------------------------------------------
  response_message += getFormHead("Separators");

#ifdef FEATURE_LED_MODES
  // LED mode
  response_message += getDropDownHeader("LED Mode:", "ledMode", true, false);
  response_message += getDropDownOption("0", "RailRoad", (current_config.ledMode == LED_RAILROAD));
  response_message += getDropDownOption("1", "Slow flash", (current_config.ledMode == LED_BLINK_SLOW));
  response_message += getDropDownOption("2", "Fast flash", (current_config.ledMode == LED_BLINK_FAST));
  response_message += getDropDownOption("3", "Double flash", (current_config.ledMode == LED_BLINK_DBL));
  response_message += getDropDownOption("4", "Always On", (current_config.ledMode == LED_ON));
  response_message += getDropDownOption("5", "Always Off", (current_config.ledMode == LED_OFF));
  response_message += getDropDownOption("6", "AM/PM", (current_config.ledMode == LED_AM_PM));
  response_message += getDropDownFooter();
#endif

#ifdef FEATURE_STATUS_LEDS
  // Status LED mode Left
  response_message += getDropDownHeader("Left Status LED Mode:", "statusModeL", true, false);
  response_message += getDropDownOption("0", "NTP", (current_config.statusModeL == STATUS_LED_MODE_NTP));
  response_message += getDropDownOption("1", "Connected", (current_config.statusModeL == STATUS_LED_MODE_ONLINE));
  response_message += getDropDownOption("2", "AM/PM", (current_config.statusModeL == STATUS_LED_MODE_AM_PM));
  response_message += getDropDownOption("3", "PIR", (current_config.statusModeL == STATUS_LED_MODE_PIR));
  response_message += getDropDownOption("4", "Off", (current_config.statusModeL == STATUS_LED_MODE_OFF));
  response_message += getDropDownOption("5", "On", (current_config.statusModeL == STATUS_LED_MODE_ON));
  response_message += getDropDownFooter();

  // Status LED mode Right
  response_message += getDropDownHeader("Right Status LED Mode:", "statusModeR", true, false);
  response_message += getDropDownOption("0", "NTP", (current_config.statusModeR == STATUS_LED_MODE_NTP));
  response_message += getDropDownOption("1", "Connected", (current_config.statusModeR == STATUS_LED_MODE_ONLINE));
  response_message += getDropDownOption("2", "AM/PM", (current_config.statusModeR == STATUS_LED_MODE_AM_PM));
  response_message += getDropDownOption("3", "PIR", (current_config.statusModeR == STATUS_LED_MODE_PIR));
  response_message += getDropDownOption("4", "Off", (current_config.statusModeR == STATUS_LED_MODE_OFF));
  response_message += getDropDownOption("5", "On", (current_config.statusModeR == STATUS_LED_MODE_ON));
  response_message += getDropDownFooter();
#endif

  // Separator dim factor how many digits the LEDs stay on for
  response_message += getDropDownHeader("Separator Dimming:", "separatorDimFactor", true, false);
  response_message += getDropDownOption("0", "Off", (current_config.separatorDimFactor == SEP_OFF));
  response_message += getDropDownOption("1", "Dim", (current_config.separatorDimFactor == SEP_DIM));
  response_message += getDropDownOption("2", "Medium", (current_config.separatorDimFactor == SEP_MED));
  response_message += getDropDownOption("3", "Bright", (current_config.separatorDimFactor == SEP_BRIGHT));
  response_message += getDropDownOption("4", "Full", (current_config.separatorDimFactor == SEP_FULL));
  response_message += getDropDownFooter();

  response_message += getSubmitButton("Set");

  response_message += getFormFoot();

  // -----------------------------------------------------------------------------
  response_message += getFormHead("Security");

  // web auth mode
  response_message += getRadioGroupHeader("Web Authentication:");
  if (current_config.webAuthentication) {
    response_message += getRadioButton("webAuthentication", " On", "on", true);
    response_message += getRadioButton("webAuthentication", " Off", "off", false);
  } else {
    response_message += getRadioButton("webAuthentication", " On", "on", false);
    response_message += getRadioButton("webAuthentication", " Off", "off", true);
  }
  response_message += getRadioGroupFooter();

  response_message += getTextInput("User Name", "webUsername", current_config.webUsername, !current_config.webAuthentication);
  response_message += getTextInput("Password", "webPassword", current_config.webPassword, !current_config.webAuthentication);

  response_message += getSubmitButton("Set");

  response_message += getFormFoot();

  // all done
  response_message += getHTMLFoot();

  server.send(200, "text/html", response_message);

  debugManager.debugMsg("Config page out");
}

// ************************************************************
// Send a value to the clock for display
// ************************************************************
void setDisplayValuePageHandler() {
  boolean valueValid = false;
  boolean timeValid = false;
  boolean formatValid = false;

  int valueToDisplay = 0;
  int valueTime = 0;
  int valueFormat = 0;
  
  checkServerArgInt("value", "value", valueValid, valueToDisplay);
  checkServerArgInt("time", "time", timeValid, valueTime);
  checkServerArgInt("format", "format", formatValid, valueFormat);

  if (valueValid) {
    valueToShow = valueToDisplay % 10000;
    valueDisplayTime = 10;
  }
  
  if (timeValid) {
    if (valueTime > 255)
      valueTime = 255;
    valueDisplayTime = valueTime;
  } else {
    valueDisplayTime = 10;
  }

  if (formatValid) {
    byte val1 = hex2bcd(valueFormat % 100);
    valueFormat = valueFormat / 100;
    byte val0 = hex2bcd(valueFormat % 100);
    valueDisplayType[0] = val0;
    valueDisplayType[1] = val1;
  }

  String response_message = getHTMLHead(getIsConnected());
  response_message += getNavBar();

  response_message += "<div class=\"container\" role=\"main\"><h3 class=\"sub-header\">Show a value on the clock</h3>";

  if (valueValid) {
    response_message += "<div class=\"alert alert-success fade in\"><strong>";
    response_message += "display value was set!";
    response_message += "</strong></div></div>";
  } else {
    response_message += "<div class=\"alert alert-error fade in\"><strong>";
    response_message += "You need to set at least the \"value\" parameter! A valid command line is http://clock.ip.address/setvalue?value=1234&time=60&format=3333";
    response_message += "</strong></div></div>";
  }

  response_message += getHTMLFoot();

  server.send(200, "text/html", response_message);
}

// ************************************************************
// Access to utility functions
// ************************************************************
void utilityPageHandler()
{
  debugMsg("Utility page in");
  String response_message = getHTMLHead(getIsConnected());
  response_message += getNavBar();

  response_message += "<hr><li><a href=\"/resetwifi\">Restart WiFi module</a></li>";
  response_message += "<hr><li><a href=\"/reset\">Clear WiFi config and restart module</a></li>";
  response_message += "<hr><li><a href=\"/update\">Update firmware</a></li>";
  response_message += "<hr><li><a href=\"/ntpupdate\">Force update from NTP now</a></li>";
  response_message += "<hr><li><a href=\"/factoryreset\">Perform factory reset</a></li>";

  response_message += getHTMLFoot();
  server.send(200, "text/html", response_message);
  debugMsg("Utility page out");
}

// ************************************************************
// Reset just the wifi
// ************************************************************
void resetWiFiPageHandler() {
  debugMsg("Reset WiFi page in");

  WiFiManager wifiManager;
  wifiManager.resetSettings();

  String response_message = getHTMLHead(getIsConnected());
  response_message += getNavBar();
  response_message += "<div class=\"alert alert-success fade in\"><strong>Attempting a restart.</strong>";
  response_message += "<script> var timer = setTimeout(function() {window.location='/'}, 10000);</script>";
  response_message += getHTMLFoot();
  server.send(200, "text/html", response_message);
  debugMsg("Reset WiFi page out");
  delay(1000);    // wait to deliver response
  ESP.restart();  // should reboot
}

// ************************************************************
// Do an NTP update now
// ************************************************************
void ntpUpdatePageHandler() {
  debugMsg("NTP Update page in");

  ntpAsync.getTimeFromNTP();

  server.sendHeader("Location", "/utility", true);
  server.send(302, "text/plain", "");

  debugMsg("NTP Update page out");
}

// ************************************************************
// Reset all the settings
// ************************************************************
void factoryResetPageHandler() {
  debugMsg("Factory Reset page in");

  factoryReset();

  server.sendHeader("Location", "/utility", true);
  server.send(302, "text/plain", "");

  debugMsg("Factory Reset page out");
}

// ************************************************************
// Called if requested page is not found
// ************************************************************
void handleNotFound() {
  debugMsg("404 page in");

  String message = "File Not Found\n\n";
  message += "URI: ";
  message += server.uri();
  message += "\nMethod: ";
  message += (server.method() == HTTP_GET) ? "GET" : "POST";
  message += "\nArguments: ";
  message += server.args();
  message += "\n";

  for (uint8_t i = 0; i < server.args(); i++)
  {
    message += " " + server.argName(i) + ": " + server.arg(i) + "\n";
  }

  server.send(404, "text/plain", message);

  debugMsg("404 page out");
}
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
