isparkes/4-digit-wemos-clock/Software/SPIFFS.cpp

//**********************************************************************************
//* ESP8266 4-Digit Nixie Clock                                                    *
//* Copyright (c) 2018-2026 Ian Sparkes. All rights reserved.                      *
//*                                                                                *
//* Free for non-commercial use. Commercial use needs a licence from the author.   *
//* See the LICENSE file in the repository root for the full terms.                *
//* Contact: nixie@protonmail.ch  |  https://www.nixieclock.biz                    *
//**********************************************************************************

#include "SPIFFS.h"

//**********************************************************************************
//**********************************************************************************
//*                               SPIFFS functions                                 *
//**********************************************************************************
//**********************************************************************************

// ************************************************************
// Test SPIFFS
// ************************************************************
boolean SPIFFS_CLOCK::testMountSpiffs() {
  boolean mounted = false;
  if (SPIFFS.begin()) {
    mounted = true;
    SPIFFS.end();
  }

  return mounted;
}

// ************************************************************
// Retrieve the config from the SPIFFS
// ************************************************************
boolean SPIFFS_CLOCK::getConfigFromSpiffs(spiffs_config_t* spiffs_config) {
  boolean loaded = false;
  if (SPIFFS.begin()) {
    debugMsg("mounted file system");
    if (SPIFFS.exists("/config.json")) {
      //file exists, reading and loading
      debugMsg("reading config file");
      File configFile = SPIFFS.open("/config.json", "r");
      if (configFile) {
        debugMsg("opened config file");
        size_t size = configFile.size();
        // Allocate a buffer to store contents of the file.
        std::unique_ptr<char[]> buf(new char[size]);

        configFile.readBytes(buf.get(), size);
        DynamicJsonBuffer jsonBuffer;
        JsonObject& json = jsonBuffer.parseObject(buf.get());
        json.printTo(Serial);
        debugMsg("\n");

        if (json.success()) {
          debugMsg("parsed json");

          spiffs_config->ntpPool = json["ntp_pool"].as<String>();
          debugMsg("Loaded NTP pool: " + spiffs_config->ntpPool);

          spiffs_config->ntpUpdateInterval = json["ntp_update_interval"].as<int>();
          debugMsg("Loaded NTP update interval: " + String(spiffs_config->ntpUpdateInterval));

          spiffs_config->tzs = json["time_zone_string"].as<String>();
          debugMsg("Loaded time zone string: " + spiffs_config->tzs);

          spiffs_config->hourMode = json["hourMode"].as<bool>();
          debugMsg("Loaded 12/24H mode: " + String(spiffs_config->hourMode));

          spiffs_config->blankLeading = json["blankLeading"].as<bool>();
          debugMsg("Loaded lead zero blanking: " + String(spiffs_config->blankLeading));

          spiffs_config->dateFormat = json["dateFormat"];
          debugMsg("Loaded date format: " + String(spiffs_config->dateFormat));

          spiffs_config->dayBlanking = json["dayBlanking"];
          debugMsg("Loaded dayBlanking: " + String(spiffs_config->dayBlanking));

          spiffs_config->blankLeading = json["fade"].as<bool>();
          debugMsg("Loaded lead fade: " + String(spiffs_config->fade));

          spiffs_config->fadeSteps = json["fadeSteps"];
          debugMsg("Loaded fadeSteps: " + String(spiffs_config->fadeSteps));

          spiffs_config->scrollback = json["scrollback"].as<bool>();
          debugMsg("Loaded lead scrollback: " + String(spiffs_config->scrollback));

          spiffs_config->scrollSteps = json["scrollSteps"];
          debugMsg("Loaded scrollSteps: " + String(spiffs_config->scrollSteps));

          spiffs_config->thresholdBright = json["thresholdBright"];
          debugMsg("Loaded thresholdBright: " + String(spiffs_config->thresholdBright));

          spiffs_config->sensitivityLDR = json["sensitivityLDR"];
          debugMsg("Loaded sensitivityLDR: " + String(spiffs_config->sensitivityLDR));

          spiffs_config->minDim = json["minDim"];
          debugMsg("Loaded minDim: " + String(spiffs_config->minDim));

          spiffs_config->sensorSmoothCountLDR = json["sensorSmoothCountLDR"];
          debugMsg("Loaded sensorSmoothCountLDR: " + String(spiffs_config->sensorSmoothCountLDR));

          spiffs_config->backlightMode = json["backlightMode"];
          debugMsg("Loaded backlight mode: " + String(spiffs_config->backlightMode));

          spiffs_config->useBLPulse = json["useBLPulse"].as<bool>();
          debugMsg("Loaded backlight pulse: " + String(spiffs_config->useBLPulse));

          spiffs_config->useBLDim = json["useBLDim"].as<bool>();
          debugMsg("Loaded backlight dim: " + String(spiffs_config->useBLDim));

          spiffs_config->redCnl = json["redCnl"];
          debugMsg("Loaded redCnl: " + String(spiffs_config->redCnl));

          spiffs_config->grnCnl = json["grnCnl"];
          debugMsg("Loaded grnCnl: " + String(spiffs_config->grnCnl));

          spiffs_config->bluCnl = json["bluCnl"];
          debugMsg("Loaded bluCnl: " + String(spiffs_config->bluCnl));

          spiffs_config->blankMode = json["blankMode"];
          debugMsg("Loaded blankMode: " + String(spiffs_config->blankMode));

          spiffs_config->blankHourStart = json["blankHourStart"];
          debugMsg("Loaded blankHourStart: " + String(spiffs_config->blankHourStart));

          spiffs_config->blankHourEnd = json["blankHourEnd"];
          debugMsg("Loaded blankHourEnd: " + String(spiffs_config->blankHourEnd));

          spiffs_config->cycleSpeed = json["cycleSpeed"];
          debugMsg("Loaded cycleSpeed: " + String(spiffs_config->cycleSpeed));

          spiffs_config->pirTimeout = json["pirTimeout"];
          debugMsg("Loaded pirTimeout: " + String(spiffs_config->pirTimeout));

          spiffs_config->useLDR = json["useLDR"];
          debugMsg("Loaded useLDR: " + String(spiffs_config->useLDR));

          spiffs_config->slotsMode = json["slotsMode"];
          debugMsg("Loaded slotsMode: " + String(spiffs_config->slotsMode));

          spiffs_config->usePIRPullup = json["usePIRPullup"];
          debugMsg("Loaded usePIRPullup: " + String(spiffs_config->usePIRPullup));

          spiffs_config->testMode = json["testMode"].as<bool>();
          debugMsg("Loaded testMode: " + String(spiffs_config->testMode));

          spiffs_config->ledMode = json["ledMode"];
          debugMsg("Loaded ledMode: " + String(spiffs_config->ledMode));

          spiffs_config->webAuthentication = json["webAuthentication"].as<bool>();
          debugMsg("Loaded webAuthentication: " + String(spiffs_config->webAuthentication));

          spiffs_config->webUsername = json["webUsername"].as<String>();
          debugMsg("Loaded webUsername: " + spiffs_config->webUsername);

          spiffs_config->webPassword = json["webPassword"].as<String>();
          debugMsg("Loaded webPassword: " + spiffs_config->webPassword);

          spiffs_config->backlightDimFactor = json["backlightDimFactor"];
          debugMsg("Loaded backlightDimFactor: " + String(spiffs_config->backlightDimFactor));

          spiffs_config->statusModeL = json["statusModeL"];
          debugMsg("Loaded statusModeL: " + String(spiffs_config->statusModeL));

          spiffs_config->statusModeR = json["statusModeR"];
          debugMsg("Loaded statusModeR: " + String(spiffs_config->statusModeR));

          spiffs_config->preheatStrength = json["preheatStrength"];
          debugMsg("Loaded preheatStrength: " + String(spiffs_config->preheatStrength));

          spiffs_config->extDimFactor = json["extDimFactor"];
          debugMsg("Loaded extDimFactor: " + String(spiffs_config->extDimFactor));

          spiffs_config->separatorDimFactor = json["separatorDimFactor"];
          debugMsg("Loaded separatorDimFactor: " + String(spiffs_config->separatorDimFactor));

          spiffs_config->doNotDimIndLEDs = json["doNotDimIndLEDs"].as<bool>();
          debugMsg("Loaded doNotDimIndLEDs: " + String(spiffs_config->doNotDimIndLEDs));

          spiffs_config->antiGhost = json["antiGhost"];
          debugMsg("Loaded antiGhost: " + String(spiffs_config->antiGhost));

          loaded = true;
        } else {
          debugMsg("failed to load json config");
        }
        debugMsg("Closing config file");
        configFile.close();
      }
    }
  } else {
    debugMsg("failed to mount FS");
  }

  SPIFFS.end();
  return loaded;
}

// ************************************************************
// Save config back to the SPIFFS
// ************************************************************
void SPIFFS_CLOCK::saveConfigToSpiffs(spiffs_config_t* spiffs_config) {
  if (SPIFFS.begin()) {
    debugMsg("mounted file system");
    debugMsg("saving config");

    DynamicJsonBuffer jsonBuffer;
    JsonObject& json = jsonBuffer.createObject();
    json["ntp_pool"] = spiffs_config->ntpPool;
    json["ntp_update_interval"] = spiffs_config->ntpUpdateInterval;
    json["time_zone_string"] = spiffs_config->tzs;
    json["hourMode"] = spiffs_config->hourMode;
    json["blankLeading"] = spiffs_config->blankLeading;
    json["dateFormat"] = spiffs_config->dateFormat;
    json["dayBlanking"] = spiffs_config->dayBlanking;
    json["fade"] = spiffs_config->fade;
    json["scrollback"] = spiffs_config->scrollback;
    json["fadeSteps"] = spiffs_config->fadeSteps;
    json["scrollSteps"] = spiffs_config->scrollSteps;
    json["thresholdBright"] = spiffs_config->thresholdBright;
    json["sensitivityLDR"] = spiffs_config->sensitivityLDR;
    json["minDim"] = spiffs_config->minDim;
    json["sensorSmoothCountLDR"] = spiffs_config->sensorSmoothCountLDR;
    json["backlightMode"] = spiffs_config->backlightMode;
    json["useBLPulse"] = spiffs_config->useBLPulse;
    json["useBLDim"] = spiffs_config->useBLDim;    
    json["redCnl"] = spiffs_config->redCnl;
    json["grnCnl"] = spiffs_config->grnCnl;
    json["bluCnl"] = spiffs_config->bluCnl;
    json["blankMode"] = spiffs_config->blankMode;
    json["blankHourStart"] = spiffs_config->blankHourStart;
    json["blankHourEnd"] = spiffs_config->blankHourEnd;
    json["cycleSpeed"] = spiffs_config->cycleSpeed;
    json["pirTimeout"] = spiffs_config->pirTimeout;
    json["useLDR"] = spiffs_config->useLDR;
    json["slotsMode"] = spiffs_config->slotsMode;
    json["usePIRPullup"] = spiffs_config->usePIRPullup;
    json["testMode"] = spiffs_config->testMode;
    json["ledMode"] = spiffs_config->ledMode;
    json["webAuthentication"] = spiffs_config->webAuthentication;
    json["webUsername"] = spiffs_config->webUsername;
    json["webPassword"] = spiffs_config->webPassword;
    json["backlightDimFactor"] = spiffs_config->backlightDimFactor;
    json["statusModeL"] = spiffs_config->statusModeL;
    json["statusModeR"] = spiffs_config->statusModeR;
    json["preheatStrength"] = spiffs_config->preheatStrength;
    json["extDimFactor"] = spiffs_config->extDimFactor;
    json["separatorDimFactor"] = spiffs_config->separatorDimFactor;
    json["doNotDimIndLEDs"] = spiffs_config->doNotDimIndLEDs;
    json["antiGhost"] = spiffs_config->antiGhost;

    File configFile = SPIFFS.open("/config.json", "w");
    if (!configFile) {
      debugMsg("failed to open config file for writing");
      configFile.close();
      return;
    }

    json.printTo(Serial);
    debugMsg("\n");

    json.printTo(configFile);
    configFile.close();
    debugMsg("Saved config");
    //end save
  } else {
    debugMsg("failed to mount FS");
  }
  SPIFFS.end();
}

// ************************************************************
// Get the statistics from the SPIFFS
// ************************************************************
boolean SPIFFS_CLOCK::getStatsFromSpiffs(spiffs_stats_t* spiffs_stats) {
  boolean loaded = false;
  if (SPIFFS.begin()) {
    debugMsg("mounted file system");
    if (SPIFFS.exists("/stats.json")) {
      //file exists, reading and loading
      debugMsg("reading stats file");
      File statsFile = SPIFFS.open("/stats.json", "r");
      if (statsFile) {
        debugMsg("opened stats file");
        size_t size = statsFile.size();
        // Allocate a buffer to store contents of the file.
        std::unique_ptr<char[]> buf(new char[size]);

        statsFile.readBytes(buf.get(), size);
        DynamicJsonBuffer jsonBuffer;
        JsonObject& json = jsonBuffer.parseObject(buf.get());
        json.printTo(Serial);
        debugMsg("\n");

        if (json.success()) {
          debugMsg("parsed stats json");

          spiffs_stats->uptimeMins = json.get<unsigned long>("uptime");
          debugMsg("Loaded uptime: " + String(spiffs_stats->uptimeMins));

          spiffs_stats->tubeOnTimeMins = json.get<unsigned long>("tubeontime");
          debugMsg("Loaded tubeontime: " + String(spiffs_stats->tubeOnTimeMins));

          loaded = true;
        } else {
          debugMsg("failed to load json config");
        }
        debugMsg("Closing stats file");
        statsFile.close();
      }
    }
  } else {
    debugMsg("failed to mount FS");
  }

  SPIFFS.end();
  return loaded;
}

// ************************************************************
// Save the statistics back to the SPIFFS
// ************************************************************
void SPIFFS_CLOCK::saveStatsToSpiffs(spiffs_stats_t* spiffs_stats) {
  if (SPIFFS.begin()) {
    debugMsg("mounted file system");
    debugMsg("saving stats");

    DynamicJsonBuffer jsonBuffer;
    JsonObject& json = jsonBuffer.createObject();
    json.set("uptime", spiffs_stats->uptimeMins);
    json.set("tubeontime", spiffs_stats->tubeOnTimeMins);

    File statsFile = SPIFFS.open("/stats.json", "w");
    if (!statsFile) {
      debugMsg("failed to open stats file for writing");
      statsFile.close();
      return;
    }

    json.printTo(Serial);
    debugMsg("\n");

    json.printTo(statsFile);
    statsFile.close();
    debugMsg("Saved stats");
    //end save
  } else {
    debugMsg("failed to mount FS");
  }
  SPIFFS.end();
}

// ************************************************************
// Output a logging message to the debug output, if set
// ************************************************************
void SPIFFS_CLOCK::debugMsg(String message) {
  if (_dbcb != NULL && _debug) {
    _dbcb("SPIFFS: " + message);
  }
}

// ************************************************************
// Set the callback for outputting debug messages
// ************************************************************
void SPIFFS_CLOCK::setDebugCallback(DebugCallback dbcb) {
  _dbcb = dbcb;
  debugMsg("Debugging started, callback set");
}

// ************************************************************
// set the update interval
// ************************************************************
void SPIFFS_CLOCK::setDebugOutput(bool newDebug) {
  _debug = newDebug;
}
