isparkes/4-digit-wemos-clock/Software/Globals.h

//**********************************************************************************
//* ESP8266 4-Digit Nixie Clock                                                    *
//* Copyright (c) 2018-2026 Ian Sparkes. All rights reserved.                      *
//*                                                                                *
//* Free for non-commercial use. Commercial use needs a licence from the author.   *
//* See the LICENSE file in the repository root for the full terms.                *
//* Contact: nixie@protonmail.ch  |  https://www.nixieclock.biz                    *
//**********************************************************************************

#ifndef __ESP_GLOBALS_H__
#define __ESP_GLOBALS_H__

#include "HtmlServer.h"
#include "DisplayDefs.h"
#include "ClockDefs.h"
#include "Transition.h"
#include "ESP_DS1307.h"
#include "ClockButton.h"

// ----------------------- Components ----------------------------

Transition transition(500, 1000, 3000); // Scroll/Scramble (Transition.h)  
DS1307 Clock;                           // RTC, uses Analogue pins A4 (SDA) and A5 (SCL)
ClockButton button1(inputPin1, true);   // Clock button debounce and handling

// ------------------------ NTP ------------------------

#define TIME_ZONE_STRING_DEFAULT "CET-1CEST,M3.5.0,M10.5.0/3"

// ------------------ Display Variables ----------------

byte numberArray[DIGIT_COUNT]          = {0, 0, 0, 0};
byte currNumberArray[DIGIT_COUNT]      = {0, 0, 0, 0};
byte displayType[DIGIT_COUNT]          = {NORMAL, NORMAL, NORMAL, NORMAL};
byte fadeState[DIGIT_COUNT]            = {0, 0, 0, 0};
byte valueDisplayTime                  = 0;
int valueToShow                        = 0;
byte valueDisplayType[DIGIT_COUNT / 2] = {NORMAL | NORMAL << 4, NORMAL | NORMAL << 4}; // All normal by default
byte ledsOffTime;

// ------------------- Config Variables ----------------

// This define to be moved
#define COUNTS_PER_DIGIT       20
float fadeStep = COUNTS_PER_DIGIT / FADE_STEPS_DEFAULT;

byte cycleCount = 0;

// ------------- Time management variables -------------

unsigned long nowMillis = 0;
unsigned long lastCheckMillis = 0;

byte currentMode = MODE_TIME;   // Initial cold start mode
byte nextMode = currentMode;
boolean triggeredThisSec = false;

unsigned int tempDisplayModeDuration;      // time for the end of the temporary display
int  tempDisplayMode;

// ---------------- Backlight management ---------------

int colors[3];
byte ledR[DIGIT_COUNT];
byte ledG[DIGIT_COUNT];
byte ledB[DIGIT_COUNT];

// ------------------ Usage statistics -----------------

unsigned long uptimeMins = 0;
unsigned long tubeOnTimeMins = 0;
int impressionsPerSec = 0;
int lastImpressionsPerSec = 0;

// ----------------- Real time clock -------------------

byte useRTC = false;  // true if we detect an RTC
boolean onceHadAnRTC = false;

// ----------------- Motion detector -------------------

unsigned long pirLastSeen = 0;
boolean pirInstalled = false;
int pirConsecutiveCounts = 300;  // set with a high value to stop the PIR being falsely detected the first time round the loop

// --------------------- Blanking ----------------------

boolean blanked = false;
byte blankSuppressStep = 0;    // The press we are on: 1 press = suppress for 1 min, 2 press = 1 hour, 3 = 1 day
unsigned long blankSuppressedMillis = 0;   // The end time of the blanking, 0 if we are not suppressed
unsigned long blankSuppressedSelectionTimoutMillis = 0;   // Used for determining the end of the blanking period selection timeout
boolean blankTubes = false;
boolean blankLEDs = false;
boolean blankSeparators = false;

// --------------- Ambient light dimming ---------------

double sensorLDRSmoothed = 0;
double sensorFactor = (double)SENSOR_SENSIT_DEFAULT / 100.0;
int ldrValue = 0;

// ----------------- Display management ----------------
boolean blinkState;

// ------------------- LED management ------------------

boolean upOrDown;

// Used to control the separator LEDs
boolean led1State;
boolean led2State;

// Strategy 3
int changeSteps = 0;
byte currentColour = 0;

#endif
