isparkes/4-digit-wemos-clock/Software/SPIFFS.h

//**********************************************************************************
//* ESP8266 4-Digit Nixie Clock                                                    *
//* Copyright (c) 2018-2026 Ian Sparkes. All rights reserved.                      *
//*                                                                                *
//* Free for non-commercial use. Commercial use needs a licence from the author.   *
//* See the LICENSE file in the repository root for the full terms.                *
//* Contact: nixie@protonmail.ch  |  https://www.nixieclock.biz                    *
//**********************************************************************************

#ifndef SPIFFS_H
#define SPIFFS_H

#include <FS.h>
#include <ArduinoJson.h>        // bblanchon/ArduinoJson (^5.13.2 - the v6/v7 API differs)

#include "ClockDefs.h"

// ------------------------ Types ------------------------

typedef void (*DebugCallback) (String);

// Used for holding the config set
typedef struct {
  String ntpPool;
  int ntpUpdateInterval;
  String tzs;
  boolean hourMode;
  int minDim;
  byte dayBlanking;
  boolean scrollback;
  boolean fade;
  byte fadeSteps;
  byte scrollSteps;
  int thresholdBright;
  int sensitivityLDR;
  int sensorSmoothCountLDR;
  byte blankHourStart;
  byte blankHourEnd;
  byte blankMode;
  boolean useLDR;
  int pirTimeout;
  boolean usePIRPullup;
  byte backlightMode;
  boolean useBLPulse;
  boolean useBLDim;
  byte redCnl;
  byte grnCnl;
  byte bluCnl;
  byte cycleSpeed;
  byte slotsMode;
  boolean blankLeading;
  byte dateFormat;
  byte ledMode;
  byte statusModeL;
  byte statusModeR;
  byte backlightDimFactor;
  boolean testMode;
  boolean webAuthentication;
  String webUsername;
  String webPassword;
  byte preheatStrength;
  byte extDimFactor;
  byte separatorDimFactor;
  boolean doNotDimIndLEDs;
  byte antiGhost;
} spiffs_config_t;

typedef struct {
  unsigned long uptimeMins = 0;
  unsigned long tubeOnTimeMins = 0;
} spiffs_stats_t;

// ----------------------------------------------------------------------------------------------------
// ------------------------------------- SPIFFS Clock Component ---------------------------------------
// ----------------------------------------------------------------------------------------------------

class SPIFFS_CLOCK
{
  public:
    void setDebugOutput(bool newDebug);
    
    boolean testMountSpiffs();

    boolean getConfigFromSpiffs(spiffs_config_t* spiffs_config);
    void    saveConfigToSpiffs(spiffs_config_t* spiffs_config);

    boolean getStatsFromSpiffs(spiffs_stats_t* spiffs_stats);
    void    saveStatsToSpiffs(spiffs_stats_t* spiffs_stats);

    // callbacks
    void setDebugCallback(DebugCallback dbcb);
  private:
    DebugCallback _dbcb;
    bool _debug = false;

    void debugMsg(String message);                        // print a debug message to the callback
};

// ----------------- Exported Variables ------------------

// Config from SPIFFS
static spiffs_config_t current_config;

// Stats from SPIFFS
static spiffs_stats_t current_stats;

// SPIFFS component
static SPIFFS_CLOCK spiffs;

#endif
