isparkes/4-digit-wemos-clock/Software/ESP_DS1307.cpp

//**********************************************************************************
//* ESP8266 4-Digit Nixie Clock                                                    *
//* Copyright (c) 2018-2026 Ian Sparkes. All rights reserved.                      *
//*                                                                                *
//* Free for non-commercial use. Commercial use needs a licence from the author.   *
//* See the LICENSE file in the repository root for the full terms.                *
//* Contact: nixie@protonmail.ch  |  https://www.nixieclock.biz                    *
//**********************************************************************************

#include <Wire.h>
#include "ESP_DS1307.h"

uint8_t DS1307::decToBcd(uint8_t val)
{
    return ( (val/10*16) + (val%10) );
}

//Convert binary coded decimal to normal decimal numbers
uint8_t DS1307::bcdToDec(uint8_t val)
{
    return ( (val/16*10) + (val%16) );
}

// only need to call if you did not already start Wire
void DS1307::begin()
{
    Wire.begin();
}

void DS1307::startClock(void)        // set the ClockHalt bit low to start the rtc
{
  Wire.beginTransmission(DS1307_I2C_ADDRESS);
  Wire.write((uint8_t)0x00);                      // Register 0x00 holds the oscillator start/stop bit
  Wire.endTransmission();
  Wire.requestFrom(DS1307_I2C_ADDRESS, 1);
  second = Wire.read() & 0x7f;       // save actual seconds and AND sec with bit 7 (sart/stop bit) = clock started
  Wire.beginTransmission(DS1307_I2C_ADDRESS);
  Wire.write((uint8_t)0x00);
  Wire.write((uint8_t)second);                    // write seconds back and start the clock
  Wire.endTransmission();
}
void DS1307::stopClock(void)         // set the ClockHalt bit high to stop the rtc
{
  Wire.beginTransmission(DS1307_I2C_ADDRESS);
  Wire.write((uint8_t)0x00);                      // Register 0x00 holds the oscillator start/stop bit
  Wire.endTransmission();
  Wire.requestFrom(DS1307_I2C_ADDRESS, 1);
  second = Wire.read() | 0x80;       // save actual seconds and OR sec with bit 7 (sart/stop bit) = clock stopped
  Wire.beginTransmission(DS1307_I2C_ADDRESS);
  Wire.write((uint8_t)0x00);
  Wire.write((uint8_t)second);                    // write seconds back and stop the clock
  Wire.endTransmission();
}

void DS1307::getTime()
{
    // Reset the register pointer
    Wire.beginTransmission(DS1307_I2C_ADDRESS);
    Wire.write((uint8_t)0x00);
    Wire.endTransmission();  
    Wire.requestFrom(DS1307_I2C_ADDRESS, 7);
    // A few of these need masks because certain bits are control bits
    second     = bcdToDec(Wire.read() & 0x7f);
    minute     = bcdToDec(Wire.read());
    hour       = bcdToDec(Wire.read() & 0x3f);// Need to change this if 12 hour am/pm
    dayOfWeek  = bcdToDec(Wire.read());
    dayOfMonth = bcdToDec(Wire.read());
    month      = bcdToDec(Wire.read());
    year       = bcdToDec(Wire.read());
}

void DS1307::setTime()
{
    Wire.beginTransmission(DS1307_I2C_ADDRESS);
    Wire.write((uint8_t)0x00);
    Wire.write(decToBcd(second));// 0 to bit 7 starts the clock
    Wire.write(decToBcd(minute));
    Wire.write(decToBcd(hour));  // If you want 12 hour am/pm you need to set bit 6 
    Wire.write(decToBcd(dayOfWeek));
    Wire.write(decToBcd(dayOfMonth));
    Wire.write(decToBcd(month));
    Wire.write(decToBcd(year));
    Wire.endTransmission();
}

void DS1307::fillByHMS(uint8_t _hour, uint8_t _minute, uint8_t _second)
{
    // assign variables
    hour = _hour;
    minute = _minute;
    second = _second;
}

void DS1307::fillByYMD(uint8_t _year, uint8_t _month, uint8_t _day)
{
    year = _year;
    month = _month;
    dayOfMonth = _day;
}

void DS1307::fillDayOfWeek(uint8_t _dow)
{
    dayOfWeek = _dow;
}

unsigned char DS1307::isRunning()
{
  Wire.beginTransmission(DS1307_I2C_ADDRESS);
  Wire.write((uint8_t)0x00); 
  Wire.endTransmission();

  // Just fetch the seconds register and check the top bit
  Wire.requestFrom(DS1307_I2C_ADDRESS, 1);
  return !(Wire.read() & 0x80);
}
