isparkes/4-digit-wemos-clock/Software/NtpAsync.h

//**********************************************************************************
//* ESP8266 4-Digit Nixie Clock                                                    *
//* Copyright (c) 2018-2026 Ian Sparkes. All rights reserved.                      *
//*                                                                                *
//* Free for non-commercial use. Commercial use needs a licence from the author.   *
//* See the LICENSE file in the repository root for the full terms.                *
//* Contact: nixie@protonmail.ch  |  https://www.nixieclock.biz                    *
//**********************************************************************************

#ifndef NtpAsync_h
#define NtpAsync_h

#include <memory>
#include <Arduino.h>
#include <ESPAsyncUDP.h>        // me-no-dev/ESPAsyncUDP (pinned to 697c75a0)
#include <ESP8266WiFi.h>
#include <DNSServer.h>          //https://github.com/esp8266/Arduino/tree/master/libraries/DNSServer

// AsyncUDP _udp;

typedef void (*DebugCallback) (String);
typedef void (*NewTimeCallback) ();

// ------------------------ NTP ------------------------

#define NTP_POOL_DEFAULT "pool.ntp.org"
#define NTP_PACKET_SIZE 48
#define TIME_ZONE_STRING_DEFAULT "CET-1CEST,M3.5.0,M10.5.0/3"
#define NTP_UPDATE_INTERVAL_DEFAULT 7261
#define NTP_UPDATE_INTERVAL_MIN 60
#define NTP_UPDATE_INTERVAL_MAX 86400

class NtpAsync
{
  public:
    void setUp();
    void setDebugOutput(bool newDebug);
    void getTimeFromNTP();
    bool getIsConnected();
    void resetDefaults();
    
    void setTZS(String newTzs);
    String getTZS();
    
    void setUpdateInterval(int updateInterval);
    int getUpdateInterval();
    
    String getNtpPool();
    void setNtpPool(String pool);
    
    unsigned long getLastUpdate();
    signed int getNextUpdate(unsigned long nowMillis);
    void resetNextUpdate();
    
    String getLastTimeFromServer();
    
    bool ntpTimeValid(unsigned long nowMillis);
    
    long getLastUpdateTimeSecs(unsigned long nowMillis);

    // callbacks
    void setDebugCallback(DebugCallback dbcb);
    void setNewTimeCallback(NewTimeCallback ntcb);
  private:
    String _ntpPool = NTP_POOL_DEFAULT;                   // The pool name we are using
    String _tzs = TIME_ZONE_STRING_DEFAULT;               // The TZ value to use
    unsigned long _lastUpdateFromServer = 0;              // The last millis() we got an update at
    String _lastTimeFromServer = "";                      // The last time we got
    int _ntpUpdateInterval = NTP_UPDATE_INTERVAL_DEFAULT; // The interval between updates in SECONDS
    unsigned long _ntpStarted = 0;
    bool _debug = false;
    AsyncUDP _udp;
    DebugCallback _dbcb;
    NewTimeCallback _ntcb;

    // print a debug message to the callback
    void debugMsg(String message);
};

#endif
