isparkes/4-digit-wemos-clock/Software/ESP_DS1307.h

//**********************************************************************************
//* ESP8266 4-Digit Nixie Clock                                                    *
//* Copyright (c) 2018-2026 Ian Sparkes. All rights reserved.                      *
//*                                                                                *
//* Free for non-commercial use. Commercial use needs a licence from the author.   *
//* See the LICENSE file in the repository root for the full terms.                *
//* Contact: nixie@protonmail.ch  |  https://www.nixieclock.biz                    *
//**********************************************************************************

#ifndef __ESP_DS1307_H__
#define __ESP_DS1307_H__

#include <Arduino.h>

#define DS1307_I2C_ADDRESS 0x68

#define MON 1
#define TUE 2
#define WED 3
#define THU 4
#define FRI 5
#define SAT 6
#define SUN 7

class DS1307
{
private:
    uint8_t decToBcd(uint8_t val);
    uint8_t bcdToDec(uint8_t val);

public:
    void begin();
    void startClock(void);
    void stopClock(void);
    void setTime(void);
    void getTime(void);
    void fillByHMS(uint8_t _hour, uint8_t _minute, uint8_t _second);
    void fillByYMD(uint8_t _year, uint8_t _month, uint8_t _day);
    void fillDayOfWeek(uint8_t _dow);
    uint8_t isRunning();
    uint8_t second;
    uint8_t minute;
    uint8_t hour; 
    uint8_t dayOfWeek;// day of week, 1 = Monday
    uint8_t dayOfMonth;
    uint8_t month;
    uint16_t year;
};

#endif
