isparkes/4-digit-wemos-clock/Software/Transition.h

//**********************************************************************************
//* ESP8266 4-Digit Nixie Clock                                                    *
//* Copyright (c) 2018-2026 Ian Sparkes. All rights reserved.                      *
//*                                                                                *
//* Free for non-commercial use. Commercial use needs a licence from the author.   *
//* See the LICENSE file in the repository root for the full terms.                *
//* Contact: nixie@protonmail.ch  |  https://www.nixieclock.biz                    *
//**********************************************************************************

#ifndef Transition_h
#define Transition_h

#include "Arduino.h"
#include "DisplayDefs.h"

extern byte numberArray[];
extern byte displayType[];
extern boolean scrollback;

class Transition
{
  public:
    Transition(int, int, int);
    void start(unsigned long);
    boolean isMessageOnDisplay(unsigned long);
    boolean scrollMsg(unsigned long);
    boolean scrambleMsg(unsigned long);
    boolean scrollInScrambleOut(unsigned long);
    void setRegularValues();
    void setAlternateValues();
    void loadRegularValues();
    void loadAlternateValues();
  private:
    int _effectInDuration;
    int _effectOutDuration;
    int _holdDuration;
    unsigned long _started;
    unsigned long _end;
    byte _regularDisplay[DIGIT_COUNT] = {0, 0, 0, 0};
    byte _alternateDisplay[DIGIT_COUNT] = {0, 0, 0, 0};
  
    unsigned long getEnd();
    int scroll(int8_t);
    int scramble(int, byte, byte);
    unsigned long hash(unsigned long);
};

#endif
