isparkes/4-digit-wemos-clock/Software/ClockUtils.cpp

//**********************************************************************************
//* ESP8266 4-Digit Nixie Clock                                                    *
//* Copyright (c) 2018-2026 Ian Sparkes. All rights reserved.                      *
//*                                                                                *
//* Free for non-commercial use. Commercial use needs a licence from the author.   *
//* See the LICENSE file in the repository root for the full terms.                *
//* Contact: nixie@protonmail.ch  |  https://www.nixieclock.biz                    *
//**********************************************************************************

#include "ClockUtils.h"

boolean useDebug = false;

String formatIPAsString(IPAddress ip) {
  return String(ip[0]) + '.' + String(ip[1]) + '.' + String(ip[2]) + '.' + String(ip[3]);
}

int getIntValue(String data, char separator, int index) {
  String result = getValue(data, separator, index);
  return atoi(result.c_str());
}

/**
   Split a string based on a separator, get the element given by index
*/
String getValue(String data, char separator, int index) {
  int found = 0;
  int strIndex[] = {0, -1};
  int maxIndex = data.length() - 1;
  for (int i = 0; i <= maxIndex && found <= index; i++) {
    if (data.charAt(i) == separator || i == maxIndex) {
      found++;
      strIndex[0] = strIndex[1] + 1;
      strIndex[1] = (i == maxIndex) ? i + 1 : i;
    }
  }
  return found > index ? data.substring(strIndex[0], strIndex[1]) : "";
}


String secsToReadableString (long secsValue) {
  long upDays = secsValue / 86400;
  long upHours = (secsValue - (upDays * 86400)) / 3600;
  long upMins = (secsValue - (upDays * 86400) - (upHours * 3600)) / 60;
  secsValue = secsValue - (upDays * 86400) - (upHours * 3600) - (upMins * 60);
  String uptimeString = "";
  if (upDays > 0) {
    uptimeString += upDays; 
    uptimeString += " d ";
  }
  if (upHours > 0) {
    uptimeString += upHours;
    uptimeString += " h "; 
  }
  if (upMins > 0) {
    uptimeString += upMins; 
    uptimeString += " m ";
  }
  uptimeString += secsValue; 
  uptimeString += " s";

  return uptimeString;
}

void grabInts(String s, int *dest, String sep) {
  int end = 0;
  for (int start = 0; end != -1; start = end + 1) {
    end = s.indexOf(sep, start);
    if (end > 0) {
      *dest++ = s.substring(start, end).toInt();
    } else {
      *dest++ = s.substring(start).toInt();
    }
  }
}

unsigned char hex2bcd (unsigned char x) {
  unsigned char y;
  y = (x / 10) << 4;
  y = y | (x % 10);
  return (y);
}

void setPinModes() {
  // Set up shift registers
  pinMode(LATCHPin, OUTPUT);
  pinMode(CLOCKPin, OUTPUT);
  pinMode(DATA1Pin, OUTPUT);

  // The LED Pins
  pinMode(LEDPin1, OUTPUT);
  pinMode(LEDPin2, OUTPUT);

  // NOTE: Grounding the input pin causes it to actuate
  pinMode(inputPin1, INPUT_PULLUP);
}

// ----------------------------------------------------------------------------------------------------
// ------------------------------------------- HTML functions -----------------------------------------
// ----------------------------------------------------------------------------------------------------

void setupDebug(boolean setUseDebug) {
  useDebug = setUseDebug;
  if (useDebug) Serial.begin(115200);
}

boolean getDebug() {
  return useDebug;
}

void debugMsg(String message) {
  if (useDebug) {
    Serial.println(message);
    Serial.flush();
  }
}

void debugMsgCont(String message) {
  if (useDebug) {
    Serial.print(message); 
  }
}

void toggleDebug() {
  setupDebug(!useDebug);
}
