isparkes/4-digit-wemos-clock/(commit log)

2018-11-05 Correct Q1-3 footprints
2018-11-09 Adjust mounting holes
2018-11-09 Move J1/J2 to back of board
2018-11-10 Put instructions on board
2018-11-26 Update to KiCAD 5
2018-12-07 LED dimming, transitions
2018-12-09 Change AMS1117 for a 7805, move LEDs
2018-12-09 Adjust LED and tube positions, remove DLS pullup
2018-12-12 Changed IN-2 pin size to 1.1mm
2018-12-20 Add pullup for I2C, clear out DS1307 front porch
2019-02-21 Enlarge the holes
2019-03-22 Remove blue LED handling, add PIR smoothing, correct Date formats, adjust minDim range, Ty's transition fix
2019-05-07 Rearrange code, encapsulate debug, web auth, add LED dimming
2019-08-30 Add new LED modes, time display caching
2020-02-24 Add schematic
2020-02-24 Added schematic
2020-05-07 Scheduled interrupt nearly there
2020-05-07 Fix slots display type
2020-06-11 Use LED manager - correct colourtime
2020-07-02 Fix 12/24h mode, button menu for min dim
2020-07-02 Correct button menu
2021-01-26 Replace incorrect neon footprint
2023-02-19 Make pin holes larger and don't segment the pin holes
2023-05-29 Update to Kicad 6
2024-01-11 Update Kicad6
2025-07-13 Update Kicad 9
2026-10-31 Update Kicad 10
2026-10-31 Move main PCB to a separate directory
2026-10-31 Update to KiCad 10
