isparkes/4-digit-wemos-clock/Hardware/4DigitIN12Main.kicad_pcb

## KiCad design Hardware/4DigitIN12Main.kicad_pcb (2026-10-31)

Schematic: 4DigitIN12Main.kicad_sch, Wemos D1 mini 4-Digit Main Board

Parts:
BT1: Battery_Cell; CR1220-CoinCell
C1, C2, C3, C4: 100nF; C_1206_HandSoldering
C6, C8, C12, C14: 100nF; C025-024X044
C7, C9, C10: 220uF; C_Radial_D6.3_L11.2_P2.5
C11: 680pF; C025-024X044
C13: 2.2uF; C_Radial_D6.3_L11.2_P2.5
D1, D3: UF4007; Diode_DO-41_SOD81_Vertical_AnodeUp
D2: 1N5819; Diode_DO-41_SOD81_Vertical_AnodeUp
J1, J2: Conn_01x10; Header_MA10-1_narrow
J3: CONN_01X02; Header_MA02-1
J4: Conn_01x03; Header_MA03-1_Small
L1: 100uH; Inductor-100mH
LED1, LED2, LED3, LED4: WS2812B
Q1: 2N3906; TO-92_inline_2N3906
Q2: IRF640; TO-220-3_H
R1: 2R2 2W; R_2W
R2, R6, R7: 10k; R-0207_2V
R3: 1k; R-0207_2V
R4: 390k; R-0207_2V
R5: 2k2; R-0207_2V
RV1: POT; Potentiometer_Trimmer_Bourns_3296X
SV1: CONN_FRONT; Header_MA04-1
SW1: SW_DIP_x01; SW_Tactile_SPST_Angled_PTS645Vx31-2LFS
U1: 74HC595; 74HC595_DIL16
U2: WeMos_mini; WeMos_D1_mini_board_flipped
U3: L7805; TO-220-3_H
U4: MC34063A; MC34063_DIL8
U5: DS1307+; DS1307_DIL8
U6: K155ID1; K155ID1_DIL16
W1: 5V; TESTPAD_P1-13
W2, W3: GND; TESTPAD_P1-13
W4: 170V; TESTPAD_P1-13
Y1: Crystal; Crystal_DS10_d1.0mm_l4.3mm_Horizontal

Connections:
/170V: C13.1, D3.1 (K), J2.6, R4.1, W4.1
/A1: J2.10, U1.4 (QE)
/A2: J2.9, U1.5 (QF)
/A3: J2.8, U1.6 (QG)
/A4: J2.7, U1.7 (QH)
/BTN1: SV1.2, SW1.1, U2.4 (D3)
/C0: J1.10, U6.8 (~Q2)
/C1: J1.9, U6.9 (~Q3)
/C2: J1.8, U6.10 (~Q7)
/C3: J1.7, U6.11 (~Q6)
/C4: J1.6, U6.13 (~Q4)
/C5: J1.5, U6.14 (~Q5)
/C6: J1.4, U6.15 (~Q1)
/C7: J1.3, U6.16 (~Q0)
/C8: J1.2, U6.1 (~Q8)
/C9: J1.1, U6.2 (~Q9)
/CLOCK: U1.11 (SRCLK), U2.13 (D6)
/DATA: U1.14 (SER), U2.14 (D7)
/DIGIT_A: U1.15 (QA), U6.3 (A)
/DIGIT_B: U1.1 (QB), U6.6 (B)
/DIGIT_C: U1.2 (QC), U6.7 (C)
/DIGIT_D: U1.3 (QD), U6.4 (D)
/DLS: J2.2, R2.1, U2.10 (A0)
/LATCH: U1.12 (RCLK), U2.12 (D5)
/LED_DATA: J4.1, LED4.4 (DIN), U2.7 (Rx)
/PIR: SV1.3, U2.3 (D4)
/SCL: R6.2, U2.6 (D1), U5.6 (SCL)
/SDA: R7.2, U2.5 (D2), U5.5 (SDA)
/T_LED1: J2.3, U2.15 (D8)
/T_LED2: J2.4, U2.11 (D0)
/VIN: C8.2, D1.1 (K), R1.2, U3.1 (IN), U4.6 (VIN)
/V_PWR_D2: D3.2 (A), L1.2, Q2.2 (D)
/V_PWR_L1: C9.1, L1.1, R1.1, U4.1 (SWCOL), U4.7 (IpkS), U4.8 (DRVCOL)
GND: BT1.2 (-), C1.1, C2.1, C3.1, C4.1, C6.2, C7.2, C8.1, C9.2, C10.2, C11.2, C12.2, C13.2, C14.2, J2.1, J3.1, J4.2, LED1.3 (GND), LED2.3 (GND), LED3.3 (GND), LED4.3 (GND), Q1.3 (C), Q2.3 (S), R3.2, RV1.2, RV1.3, SV1.1, SW1.2, U1.8 (GND), U1.13 (G), U2.2 (GND), U3.2 (GND), U4.4 (GND), U5.4 (GND), U6.12 (GND), W2.1, W3.1
unnamed: BT1.1 (+), U5.3 (VBAT)
unnamed: C11.1, U4.3 (TIMCAP)
unnamed: C12.1, R4.2, R5.1, U4.5 (COMINV)
unnamed: D1.2 (A), J3.2
unnamed: D2.1 (K), Q1.1 (E), Q2.1 (G)
unnamed: D2.2 (A), Q1.2 (B), R3.1, U4.2 (SWEM)
unnamed: LED1.4 (DIN), LED2.2 (DOUT)
unnamed: LED2.4 (DIN), LED3.2 (DOUT)
unnamed: LED3.4 (DIN), LED4.2 (DOUT)
unnamed: R5.2, RV1.1
unnamed: U5.1 (XTAL1), Y1.1
unnamed: U5.2 (XTAL2), Y1.2
VCC: C1.2, C2.2, C3.2, C4.2, C6.1, C7.1, C10.1, C14.1, J2.5, J4.3, LED1.1 (VCC), LED2.1 (VCC), LED3.1 (VCC), LED4.1 (VCC), R2.2, R6.1, R7.1, SV1.4, U1.10 (SRCLR), U1.16 (VCC), U2.1 (5V), U3.3 (OUT), U5.8 (VCC), U6.5 (VCC), W1.1

Notes on the sheet:
High Voltage Generator
WS2812 backlight Chain
Power regulator
Controller
Shifters
Test Points
Cathode control
RTC (option)
Connectors to display board
WS2812 test points
Front panel components

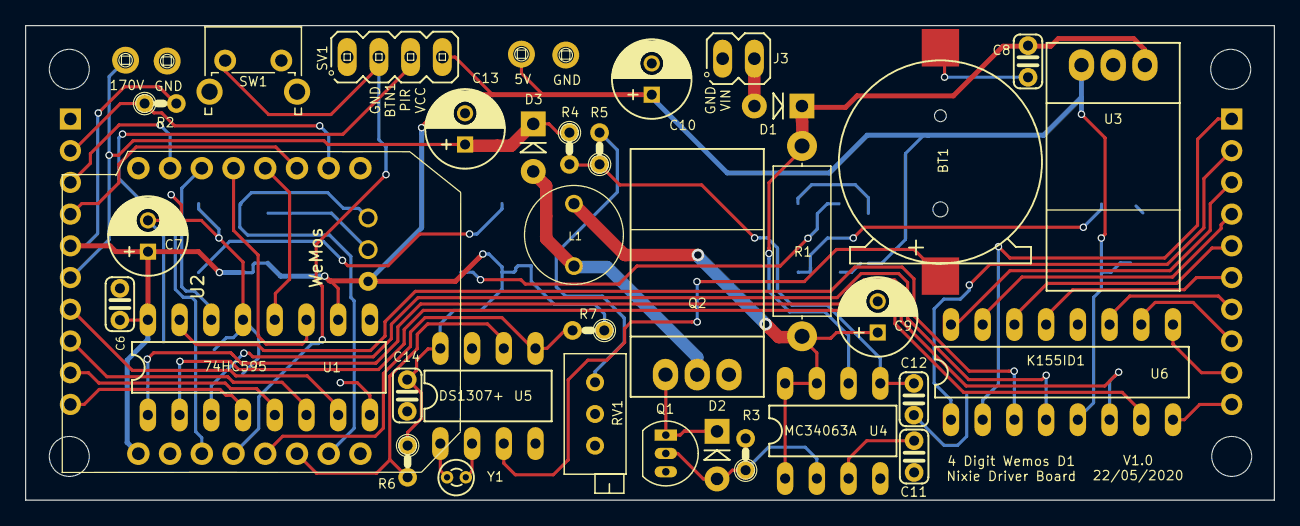
[picture p4: board 4DigitIN12Main.kicad_pcb from above]

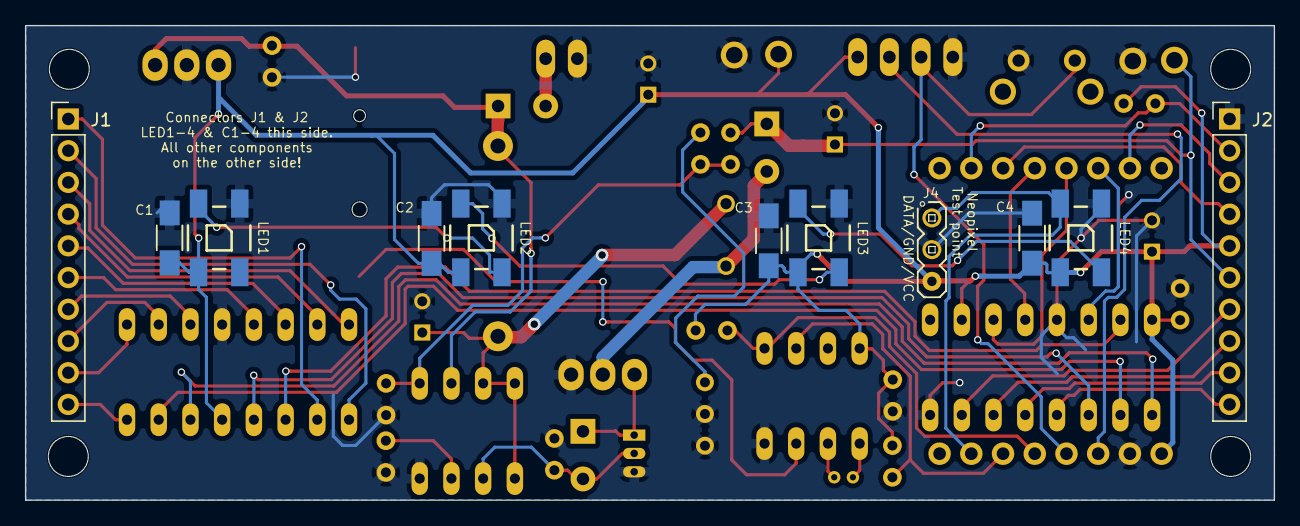
[picture p5: board 4DigitIN12Main.kicad_pcb from below]

Board: 2 copper layers, 100.0 x 38.0 mm, 53 parts (11 on the bottom side), 47 nets.

Other parts of the board:
MH1, MH1#2, MH1#3, MH1#4: MountingHole_3.2mm_M3
